3XChehe/project-3/TaiLieu_DroneFC_CRSF_DShot.docx

TÀI LIỆU KỸ THUẬT

DroneFC_CRSF_DShot

Firmware Điều Khiển Quadcopter trên ESP32

Thành phần | Linh kiện
Vi điều khiển | ESP32 WROOM32 38Pin
IMU | ICM-20602 (SPI, 10 MHz)
Cảm biến áp suất | BMP388 (I2C, 400 kHz)
Bộ thu RC | Radiomaster RP3 ELRS 2.4 GHz — CRSF 420000 baud
ESC | GOKU G55M 4-in-1 BLHeli32 — DShot600 qua RMT
Động cơ | RS2205 2300KV, khung 5", pin 3S 2200 mAh
Tay điều khiển | Pocket Crush ELRS (EdgeTX)

# MỤC LỤC

1 Tổng quan hệ thống

1.1 Kiến trúc phần cứng

1.2 Kiến trúc phần mềm — FreeRTOS

2 Giao tiếp CRSF (Crossfire Serial Protocol)

2.1 Đặc điểm giao thức

2.2 Cấu trúc khung dữ liệu CRSF

2.3 Thuật toán giải mã

2.4 Xử lý mất sóng (Failsafe)

3 Giao thức DShot600

3.1 Tại sao dùng DShot thay PWM?

3.2 Cấu trúc frame DShot

3.3 Triển khai qua RMT của ESP32

3.4 Quy đổi giá trị nội bộ → DShot

4 Đọc IMU — ICM-20602 qua SPI

4.1 Khởi tạo và hiệu chỉnh

4.2 Đọc số liệu thô

4.3 Hiệu chỉnh gyro (bias)

4.4 Hiệu chỉnh gia tốc kế (offset)

5 Ước lượng góc — Bộ lọc Kalman 1D

5.1 Vấn đề khi dùng riêng gyro hoặc riêng accelerometer

5.2 Kalman 1D: mô hình và phương trình

5.3 Tham số và cách chỉnh

6 Cảm biến áp suất BMP388 qua I2C

6.1 Cấu hình ODR / OSR / IIR

6.2 Bù nhiệt độ và áp suất

6.3 Đo cao độ gốc

7 Ước lượng độ cao — Kalman 2 trạng thái

7.1 Mô hình trạng thái

7.2 Bước dự đoán (Predict)

7.3 Bước hiệu chỉnh (Update)

7.4 Tham số và cách chỉnh

8 Thuật toán điều khiển PID xếp tầng

8.1 Tổng quan kiến trúc cascade

8.2 Bộ PID rời rạc — công thức chi tiết

8.3 Tầng ngoài: Góc nghiêng (Attitude)

8.4 Tầng trong: Tốc độ góc (Rate)

8.5 Tầng độ cao: Tốc độ thẳng đứng (Climb)

8.6 Bộ Mixer quad-X

8.7 Anti-windup và bleed integrator

9 Các chế độ bay

9.1 Chế độ Angle

9.2 Chế độ Alt Hold

9.3 Chế độ Failsafe

10 Hướng dẫn chỉnh PID

10.1 Nguyên tắc chỉnh cascade

10.2 Chỉnh tầng Rate

10.3 Chỉnh tầng Attitude

10.4 Chỉnh tầng Alt Hold

11 Debug và công cụ chẩn đoán

# 1. Tổng quan hệ thống

## 1.1 Kiến trúc phần cứng

Hệ thống firmware DroneFC_CRSF_DShot chạy trên vi điều khiển ESP32 WROOM32, kết nối với các linh kiện ngoại vi thông qua các giao thức chuẩn công nghiệp:

- ICM-20602 (IMU — gia tốc kế + con quay): giao tiếp SPI tốc độ 10 MHz, chip-select tại GPIO5.
- BMP388 (cảm biến áp suất để đo độ cao): giao tiếp I2C 400 kHz (Fast Mode), SDA=GPIO21, SCL=GPIO22, địa chỉ 0x76.
- Radiomaster RP3 ELRS (bộ thu RC): xuất giao thức CRSF qua UART2 (GPIO16/17), tốc độ 420000 baud.
- GOKU G55M 4-in-1 ESC BLHeli32: nhận lệnh DShot600 số qua 4 chân GPIO (27, 26, 25, 33), mỗi chân dùng 1 kênh RMT của ESP32.
- 4 motor RS2205 2300KV được điều khiển theo cấu hình quad-X tiêu chuẩn.

## 1.2 Kiến trúc phần mềm — FreeRTOS

Firmware sử dụng FreeRTOS (tích hợp sẵn trong Arduino ESP32) để chạy đồng thời ba tác vụ (task) với mức ưu tiên và tần số khác nhau trên hai lõi CPU:

Task | Core | Tần số | Ưu tiên | Chức năng
control_task | Core 1 | 500 Hz (2 ms) | 5 (cao nhất) | Đọc IMU, ước lượng góc/độ cao, PID, mixer, xuất ESC
rc_task | Core 0 | 500 Hz (2 ms) | 4 | Giải mã giao thức CRSF từ RP3, ghi shared_rc_ch[]
baro_task | Core 0 | 100 Hz (10 ms) | 2 | Đọc BMP388, ghi shared_baro_alt_m, in debug Serial

Giao tiếp giữa các task sử dụng Mutex (SemaphoreHandle_t) để bảo vệ vùng dữ liệu chung. Có ba mutex: mtx_rc (bảo vệ shared_rc_ch[]), mtx_baro (bảo vệ shared_baro_alt_m), và mtx_tlm (bảo vệ các biến telemetry để in debug). control_task dùng xSemaphoreTake(..., 0) — không chờ — để không bao giờ bị chặn, đảm bảo vòng điều khiển 500 Hz luôn chạy đúng chu kỳ.

# 2. Giao tiếp CRSF (Crossfire Serial Protocol)

## 2.1 Đặc điểm giao thức

CRSF (Crossfire Serial Protocol) là giao thức nối tiếp số được phát triển bởi Team BlackSheep (TBS), sau đó được ExpressLRS (ELRS) áp dụng rộng rãi. Radiomaster RP3 ELRS 2.4 GHz xuất dữ liệu kênh RC qua giao thức này. Đặc điểm nổi bật so với SBUS truyền thống:

- Tốc độ baud: 420000 — nhanh hơn SBUS (100000) gần 4×.
- Không đảo tín hiệu (non-inverted), ngược với SBUS phải đảo phần cứng.
- Format 8N1 (8 bit dữ liệu, không parity, 1 bit stop).
- Có CRC-8/DVB-S2 bảo vệ từng khung — rất hiếm lỗi bit không được phát hiện.
- ELRS ở chế độ 500 Hz gửi 1 khung mỗi 2 ms — đồng bộ tự nhiên với rc_task 500 Hz.
- Hỗ trợ telemetry hai chiều (từ FC lên TX) qua cùng cặp dây UART.
- 16 kênh trong mỗi khung (giống SBUS, nhưng có địa chỉ và CRC).

## 2.2 Cấu trúc khung dữ liệu CRSF

Mỗi khung CRSF "RC Channels Packed" gồm các trường theo thứ tự:

[ADDR 1B] [LEN 1B] [TYPE 1B] [PAYLOAD 22B] [CRC 1B] → Tổng 26 byte

ADDR : 0xC8 (Flight Controller) hoặc 0xEE (Broadcast)

LEN : số byte từ TYPE đến hết CRC = 22 + 1 + 1 = 24

TYPE : 0x16 = RC Channels Packed

PAYLOAD: 16 kênh × 11 bit = 176 bit = 22 byte, xếp liên tiếp không padding

CRC : CRC-8/DVB-S2, tính từ byte TYPE đến hết PAYLOAD (23 byte)

Giá trị mỗi kênh trong payload nằm trong khoảng 172–1811 (11-bit unsigned). Sau khi giải mã, firmware ánh xạ tuyến tính về dải quen thuộc 990–2010 (tương thích với thang 1000–2000 µs của PWM truyền thống):

ch_us = map(raw, 172, 1811, 990, 2010)

Giá trị giữa (stick ở trung tâm): raw = 992 → ch_us ≈ 1500

## 2.3 Thuật toán giải mã — Máy trạng thái

Hàm crsf_process_byte() thực hiện máy trạng thái (state machine) gom từng byte từ UART vào bộ đệm và xác nhận khung khi đủ dữ liệu:

- Bước 1 — Đồng bộ: Chờ byte addr (0xC8 hoặc 0xEE). Mọi byte trước đó bị bỏ qua. Khi nhận được byte addr hợp lệ, bắt đầu ghi vào bộ đệm và đặt cờ crsf_in_frame = true.
- Bước 2 — Đọc LEN: Byte thứ 2 là trường LEN. Kiểm tra 2 ≤ LEN ≤ 62; nếu ngoài giới hạn, reset máy trạng thái.
- Bước 3 — Gom payload: Tiếp tục nhận byte cho đến khi tổng số byte nhận = LEN + 2 (addr + len + nội dung).
- Bước 4 — Kiểm tra CRC: Tính CRC-8/DVB-S2 trên byte TYPE đến hết PAYLOAD, so sánh với byte CRC nhận được. Nếu không khớp, bỏ khung.
- Bước 5 — Giải mã kênh: Nếu TYPE = 0x16, gọi crsf_decode_channels() để tách 16 kênh 11-bit từ 22 byte payload.

Cách tách bit kênh — ví dụ kênh 0 và kênh 1:

ch[0] = (payload[0] | (payload[1] << 8)) & 0x07FF // 11 bit thấp nhất

ch[1] = (payload[1] >> 3 | (payload[2] << 5)) & 0x07FF // dịch 11 bit tiếp theo

Kỹ thuật này giống hệt SBUS về cách đóng gói bit. Mỗi kênh lấy 11 bit liên tiếp từ dòng byte, bất kể ranh giới byte, bằng cách dịch bit và mask 0x07FF.

## 2.4 Xử lý mất sóng (Failsafe)

Hàm rc_update() trả về true khi còn sóng, false khi mất sóng. Điều kiện mất sóng: không nhận được khung hợp lệ nào trong vòng 200 ms (hằng số CRSF_TIMEOUT_MS). Khi rc_ok = false, control_task kích hoạt MODE_FAILSAFE: drone giữ nguyên góc 0° và hạ độ cao với tốc độ 60 cm/s cho đến khi chạm đất rồi tự disarm.

# 3. Giao thức DShot600

## 3.1 Tại sao dùng DShot thay PWM?

Tiêu chí | PWM | DShot600
Loại tín hiệu | Analog (độ rộng xung) | Số (chuỗi bit)
Tần số cập nhật | 50–400 Hz (thường 391 Hz) | Lên đến 8000 Hz
Hiệu chỉnh ESC | Cần calibrate min/max | Không cần
Noise immunity | Thấp (nhiễu làm lệch xung) | Cao (CRC kiểm tra)
Telemetry | Không có | Có (tốc độ, dòng, nhiệt độ)
Độ trễ | ~2 ms (1 chu kỳ PWM) | <0.1 ms

## 3.2 Cấu trúc frame DShot

Mỗi frame DShot gồm 16 bit, gửi theo thứ tự MSB-first:

| 11 bit throttle | 1 bit telemetry | 4 bit CRC |

bit15 ......... bit5 bit4 bit3...bit0

Ý nghĩa giá trị throttle:

0 : Disarmed (motor tắt hoàn toàn)

1–47 : Lệnh đặc biệt (beep, đảo chiều, lưu cài đặt...)

48 : Idle tối thiểu khi đã armed (motor quay chậm)

2047 : Full throttle

Tính CRC DShot — XOR ba nhóm 4 bit của 12 bit (throttle + telemetry):

value = (throttle << 1) | telem_bit

crc = (value ^ (value >> 4) ^ (value >> 8)) & 0x0F

frame = (value << 4) | crc

Mã hóa từng bit bằng độ rộng xung (DShot600 — 600 kbit/s):

Bit '1': HIGH 1.25 µs (100 ticks@80MHz) + LOW 0.42 µs (34 ticks)

Bit '0': HIGH 0.625 µs (50 ticks@80MHz) + LOW 1.045 µs (84 ticks)

Chu kỳ bit = 1.67 µs → thời gian 1 frame = 16 × 1.67 ≈ 26.7 µs

## 3.3 Triển khai qua RMT của ESP32

ESP32 có ngoại vi RMT (Remote Control Transceiver) — bộ tạo/phân tích xung phần cứng. Firmware dùng 4 kênh RMT (CHANNEL_0 đến CHANNEL_3) cho 4 motor, mỗi kênh độc lập. Ưu điểm: CPU không bị chiếm trong khi phát xung — RMT tự động phát theo DMA trong khi control_task tiếp tục tính toán.

Cấu hình RMT:

clk_div = 1 → clock 80 MHz, 1 tick = 12.5 ns

mem_block_num = 1 → 64 item, đủ cho 16 bit DShot + 1 end marker

idle_level = LOW → line ở mức 0 giữa các frame (giống chuẩn DShot)

rmt_write_items(..., false) → non-blocking, không chờ xong

## 3.4 Quy đổi giá trị nội bộ → DShot

Để không phải sửa logic PID và mixer, firmware giữ nguyên thang nội bộ 800–1600 (tương tự PWM µs cũ), chỉ chuyển đổi ngay trước khi gửi:

internal ≤ ESC_IDLE (800) → DShot 0 (disarmed)

internal < ESC_MIN_ARMED (900) → DShot 0 (dưới mức arm)

ESC_MIN_ARMED..ESC_MAX (900..1600) → DShot 48..2047 (map tuyến tính)

# 4. Đọc IMU — ICM-20602 qua SPI

## 4.1 Khởi tạo

Firmware cấu hình ICM-20602 với các thang đo rộng nhất để phù hợp drone racing:

ACCEL_CONFIG = 0x18 → thang ±16g (ACC_LSB_PER_G = 2048 LSB/g)

GYRO_CONFIG = 0x18 → thang ±2000°/s (GYRO_LSB_PER_DPS = 16.4 LSB/°s)

CONFIG (DLPF gyro) → IMU_DLPF_GYRO = 0x06 (bộ lọc thông thấp phần cứng)

ACCEL_CONFIG2 (DLPF acc) → IMU_DLPF_ACC = 0x05

DLPF (Digital Low Pass Filter) tích hợp trong chip giúp lọc nhiễu tần số cao trước khi dữ liệu vào thanh ghi, giảm nhiễu do rung động khung.

## 4.2 Đọc số liệu thô

Firmware đọc 6 thanh ghi accelerometer (ACCEL_XOUT_H đến ACCEL_ZOUT_L) và 6 thanh ghi gyroscope (GYRO_XOUT_H đến GYRO_ZOUT_L) trong hai giao dịch SPI riêng. Với SPI, bit7 của byte địa chỉ = 1 để đọc, = 0 để ghi.

// Đọc accelerometer (burst read 6 byte)

SPI.transfer(REG_ACCEL_XOUT_H | 0x80); // bit7=1: read

ax = (SPI.transfer(0) << 8) | SPI.transfer(0);

// Tương tự cho ay, az, gx, gy, gz

Quy đổi từ số nguyên thô (LSB) sang đơn vị vật lý:

rate_roll_dps = gx_lsb / 16.4f [°/s]

acc_x_g = ax_lsb / 2048.0f [g]

## 4.3 Hiệu chỉnh gyro (Bias Calibration)

Khi nguồn cấp lần đầu, gyro bị offset (bias) — tức là ngay cả khi drone đứng yên, nó vẫn báo một tốc độ xoay khác 0. Firmware đo bias này và trừ đi trong mọi lần đọc:

- Lấy 500 mẫu liên tiếp (~5 ms/mẫu). Tính tổng roll, pitch, yaw.
- So sánh với đợt đo trước. Nếu lệch > STABLE_LIMIT (40 LSB) thì đo lại.
- Khi hai đợt đo liên tiếp ổn định: bias = tổng / 500 (°/s).
- Sau đó mọi lần đọc gyro đều trừ bias: rate = raw - bias.

Vòng lặp ổn định đảm bảo nếu người dùng đang cầm drone lúc cắm điện, bias đo được sẽ sai và firmware tự đo lại cho đến khi drone đứng yên thật sự.

## 4.4 Hiệu chỉnh gia tốc kế (Offset)

Gia tốc kế có thể bị lệch cơ học do cảm biến gắn không hoàn hảo trên PCB. Khi drone nằm phẳng, lý tưởng phải đọc X=0g, Y=0g, Z=+1g. Firmware có chế độ hiệu chỉnh gia tốc kế (bật #define CALIBRATE_ACCEL):

- Đo trung bình 2000 mẫu (4 giây), drone phải nằm hoàn toàn phẳng.
- In ra 3 giá trị offset cần gán vào ACC_OFFSET_X/Y/Z_G.
- Kiểm tra: nếu Z < 0.80g → drone bị lật ngược; nếu |X|>0.30g hoặc |Y|>0.30g → bề mặt không phẳng.

#define ACC_OFFSET_X_G -mean_x

#define ACC_OFFSET_Y_G -mean_y

#define ACC_OFFSET_Z_G (1.0 - mean_z)

Offset được cộng vào mỗi lần đọc: acc_x = raw_x + ACC_OFFSET_X_G

# 5. Ước lượng góc — Bộ lọc Kalman 1D

## 5.1 Vấn đề khi dùng riêng một nguồn

Có hai cách đo góc nghiêng (roll/pitch), mỗi cách có nhược điểm riêng:

- Chỉ dùng Gyroscope: tích phân tốc độ góc → góc. Chính xác trong ngắn hạn, nhưng tích phân tích lũy sai số (trôi góc) theo thời gian.
- Chỉ dùng Accelerometer: tính góc từ vectơ gia trọng lực. Không trôi về dài hạn, nhưng rất nhạy với rung động và gia tốc phi tuyến khi drone cơ động.

Giải pháp: Bộ lọc Kalman 1D kết hợp cả hai — gyro cung cấp dự đoán nhanh, accelerometer kéo về đúng hướng khi có sai lệch.

## 5.2 Kalman 1D: mô hình và phương trình

Trạng thái là góc (một chiều). Mô hình:

Dự đoán (Predict):

θ_pred = θ_prev + Δt × ω_gyro // tích phân gyro

P_pred = P_prev + Δt² × σ_process² // phương sai tăng dần

Hiệu chỉnh (Update):

K = P_pred / (P_pred + σ_measure²) // Kalman gain

θ = θ_pred + K × (θ_acc - θ_pred) // kéo về phép đo

P = (1 - K) × P_pred // thu hẹp phương sai

Trong code (hàm imu_kalman_1d):

state_deg += DT_CTRL * rate_dps; // DT_CTRL = 0.002s

variance += DT_CTRL * DT_CTRL * 1.0 * 1.0;// σ_process = 1 °/s

gain = variance / (variance + 3.0*3.0); // σ_measure = 3°

state_deg += gain * (measure_deg - state_deg);

variance = (1.0 - gain) * variance;

Góc từ accelerometer được tính bằng hàm atan2:

acc_roll_deg = atan(ay / sqrt(ax² + az²)) × RAD_TO_DEG

acc_pitch_deg = -atan(ax / sqrt(ay² + az²)) × RAD_TO_DEG

## 5.3 Tham số và cách chỉnh

• σ_process = 1 °/s: Độ lệch chuẩn nhiễu gyro. Tăng → tin gyro ít hơn, bộ lọc kéo về accelerometer mạnh hơn (phản ứng chậm hơn với rung động).

• σ_measure = 3°: Độ lệch chuẩn nhiễu accelerometer. Tăng → tin accelerometer ít hơn, bộ lọc phụ thuộc gyro nhiều hơn (có thể trôi góc lâu hơn).

• P_init = 4 (2²): Phương sai ban đầu. Giá trị nhỏ = khởi động tin góc ban đầu; giá trị lớn = không tin, hội tụ nhanh về accelerometer.

⚠ Kalman 1D này không xử lý trục yaw vì không có la bàn (magnetometer). Yaw chỉ được điều khiển theo tốc độ xoay (rate control), không theo góc tuyệt đối.

# 6. Cảm biến áp suất BMP388 qua I2C

## 6.1 Cấu hình ODR / OSR / IIR

Firmware cấu hình BMP388 với các thông số sau (đã tối ưu cho Alt Hold):

ODR = 50 Hz (1 mẫu mỗi 20 ms) — đủ cho alt hold, giảm nhiễu tốt hơn 200 Hz

OSR áp suất = x8 — lấy mẫu bội 8 lần rồi trung bình, độ phân giải cao hơn

OSR nhiệt độ = x1 — không cần bội vì bù nhiệt không yêu cầu chính xác cao

IIR filter = 3 — bộ lọc IIR phần cứng trong chip, giảm nhiễu áp suất

ODR và OSR phải tương thích theo ràng buộc thời gian của datasheet Bosch. Thời gian đo: 234 + (392 + 2^3 × 2020) + (163 + 2020) ≈ 18.97 ms. Chu kỳ ODR 50 Hz = 20 ms, vừa lọt. Nếu đặt ODR nhanh hơn sẽ bị conf_err.

## 6.2 Bù nhiệt độ và áp suất

BMP388 lưu hệ số hiệu chỉnh riêng cho từng chip trong thanh ghi CALIB (21 byte). Hai hàm baro_compensate_temp() và baro_compensate_press() thực hiện bù theo đúng phương trình polynomial do Bosch định nghĩa trong datasheet. Sau đó, áp suất đã bù (Pa) được chuyển sang độ cao (m) bằng công thức khí quyển chuẩn ISA:

altitude_m = 44330 × (1 − (P / P0)^0.1903)

với P0 = 101325 Pa (áp suất ngang mực nước biển tiêu chuẩn)

## 6.3 Đo cao độ gốc

Lúc khởi động, hàm baro_measure_reference() lấy trung bình 50 mẫu hợp lệ để xác định baro_alt_ref_m — cao độ tuyệt đối của điểm cất cánh. Sau đó, baro_get_altitude_m() = baro_alt_abs_m − baro_alt_ref_m cho ra độ cao tương đối so với điểm cất cánh (≈ 0 khi đặt xuống đất).

# 7. Ước lượng độ cao — Kalman 2 trạng thái

## 7.1 Mô hình trạng thái

Bộ lọc Kalman 2 trạng thái ước lượng đồng thời độ cao z (cm) và tốc độ thẳng đứng vz (cm/s). Đầu vào (control input) là gia tốc thẳng đứng đã trừ trọng lực, lấy từ IMU. Phép đo là độ cao từ barometer.

Vector trạng thái: S = [z, vz]ᵀ

Đầu vào: u = acc_earth_z (cm/s²)

Phép đo: M = baro_alt (cm)

Ma trận chuyển trạng thái F:

F = [1 Δt ] (z mới = z + vz×Δt)

[0 1 ] (vz mới = vz)

Ma trận đầu vào G:

G = [0.5×Δt²] (z tăng do gia tốc)

[ Δt ] (vz tăng tuyến tính)

Ma trận quan sát H = [1, 0] (chỉ đo z, không đo vz)

## 7.2 Bước dự đoán (Predict)

S = F·S + G·u // dự đoán trạng thái mới

P = F·P·Fᵀ + Q // dự đoán hiệp phương sai sai số

với Q = G·Gᵀ × σ_acc² = G·Gᵀ × 4² (σ_acc = 4 cm/s²)

## 7.3 Bước hiệu chỉnh (Update)

L = H·P·Hᵀ + R // hiệp phương sai phần dư (1×1 scalar)

K = P·Hᵀ / L // Kalman gain (2×1)

S = S + K·(M − H·S) // hiệu chỉnh theo phép đo baro

P = (I − K·H)·P // cập nhật hiệp phương sai

với R = σ_baro² = 30² = 900 cm²

Lưu ý quan trọng: Firmware gọi CẢ predict lẫN update ở MỖI vòng 500 Hz, kể cả khi baro chưa có mẫu mới (baro chỉ có 50 Hz). Lý do: với bộ tham số này, Kalman gain K rất nhỏ. Chỉ bằng cách áp dụng 500 lần/giây mới đủ lực kéo ước lượng bám theo baro. Nếu chỉ update khi baro có mẫu mới (~50 Hz), tốc độ thẳng đứng vz sẽ tích phân thuần từ gia tốc và trôi vô hạn.

## 7.4 Tham số và cách chỉnh

• σ_acc = 4 cm/s²: Nhiễu gia tốc giả định. Tăng → P tăng nhanh hơn → K lớn hơn → tin baro nhiều hơn. Giảm → tin IMU nhiều hơn, drone ít bị baro nhiễu nhưng có thể trôi cao độ.

• σ_baro = 30 cm: Nhiễu barometer giả định. Tăng → R lớn → K nhỏ → bộ lọc ít tin baro. Giảm → tin baro nhiều hơn, nhưng dễ bị nhiễu baro làm drone nhảy độ cao.

# 8. Thuật toán điều khiển PID xếp tầng

## 8.1 Tổng quan kiến trúc cascade

Firmware dùng kiến trúc PID xếp tầng (cascade / nested PID) — đây là cấu trúc tiêu chuẩn trong hầu hết flight controller hiện đại (Betaflight, PX4, ArduPilot):

┌────────────────────────────────────────────────────────────────┐

│ TẦY NGOÀI (Attitude/Angle): │

│ setpoint_angle (°) → [PID_TILT] → setpoint_rate (°/s) │

│ │

│ TẦNG TRONG (Rate): │

│ setpoint_rate (°/s) → [PID_RATE] → u (lệnh motor) │

│ │

│ TẦNG ĐỘ CAO (Alt Hold): │

│ setpoint_climb (cm/s) → [PID_CLIMB] → u_throttle │

└────────────────────────────────────────────────────────────────┘

Ưu điểm của cascade: tầng trong (Rate) phản ứng rất nhanh với biến động tốc độ góc (nhiễu gió, va chạm), trong khi tầng ngoài (Attitude) điều chỉnh chậm hơn để theo góc mong muốn. Tách biệt này giúp chỉnh từng tầng độc lập và dễ dàng hơn nhiều.

## 8.2 Bộ PID rời rạc — công thức chi tiết

Hàm pid_step() thực hiện PID rời rạc với:

• Khâu tỉ lệ P:

p_term = Kp × error

• Khâu tích phân I (quy tắc hình thang — Trapezoidal integration):

integral += Ki × (error + prev_error) × Δt / 2

// Hình thang: trung bình sai số hiện tại và trước, chính xác hơn hình chữ nhật

integral = clamp(integral, -I_LIMIT, +I_LIMIT) // chống windup

• Khâu vi phân D (sai phân lùi — Backward difference):

d_term = Kd × (error - prev_error) / Δt

// Sai phân lùi: an toàn hơn sai phân trung tâm, không nhìn trước

• Đầu ra tổng và giới hạn:

u = p_term + integral + d_term

u = clamp(u, -U_LIMIT, +U_LIMIT)

prev_error = error // lưu cho vòng tiếp theo

## 8.3 Tầng ngoài: Góc nghiêng (Attitude)

Nhận góc mong muốn (roll_sp, pitch_sp) từ cần gạt, so sánh với góc thực từ Kalman, xuất tốc độ góc mong muốn cho tầng trong:

rate_roll_sp = pid_tilt_roll (roll_deg, roll_sp_deg) // KP=10, KI=0, KD=0

rate_pitch_sp = pid_tilt_pitch(pitch_deg, pitch_sp_deg) // KP=10, KI=0, KD=0

KI=0 và KD=0 ở tầng này là chủ ý: tầng ngoài chỉ cần P đơn giản vì sai số góc tích phân đã được tầng trong xử lý. KP_TILT=10 nghĩa là: lệch 1° → yêu cầu tốc độ xoay 10°/s.

## 8.4 Tầng trong: Tốc độ góc (Rate)

Nhận tốc độ góc mong muốn từ tầng ngoài, so sánh với tốc độ thực từ gyro, xuất tín hiệu điều khiển motor (u_roll, u_pitch, u_yaw):

u_roll = pid_rate_roll (rate_roll_dps, rate_roll_sp) // KP=0.5, KI=1.4, KD=0.03

u_pitch = pid_rate_pitch(rate_pitch_dps, rate_pitch_sp) // KP=0.5, KI=1.4, KD=0.03

u_yaw = pid_rate_yaw (rate_yaw_dps, yaw_rate_sp) // KP=1.0, KI=10, KD=0

Yaw chỉ có tầng Rate (không có tầng Attitude) vì không đo góc yaw tuyệt đối. Cần gạt Rudder trực tiếp đặt tốc độ xoay mong muốn (°/s).

## 8.5 Tầng độ cao: Tốc độ thẳng đứng (Climb)

Nhận tốc độ lên xuống mong muốn (climb_sp_cms) từ cần Throttle (ở chế độ Alt Hold), so sánh với tốc độ thực từ Kalman độ cao, xuất bù ga:

u_throttle = ESC_IDLE + pid_climb(kf_climb_cms, climb_sp_cms) // KP=3, KI=15, KD=0

Hàm pid_step_climb() có hai điểm khác biệt so với PID thông thường:

- Khâu tích phân KHÔNG được phép âm (tối thiểu = 0). Lý do: khâu tích phân gánh phần ga treo máy (hover throttle), không được kéo ga xuống âm vì drone cần một lượng ga tối thiểu để lơ lửng.
- Khâu tỉ lệ bị chặn riêng (P_LIM_CLIMB = 200). Lý do: nhiễu baro đột ngột (do thay đổi áp suất, cánh quạt tạo áp...) không được đẩy ga vọt lên mạnh.

## 8.6 Bộ Mixer quad-X

Sau khi PID tính ra u_roll, u_pitch, u_yaw, u_throttle, Mixer kết hợp chúng thành lệnh cho từng motor theo cấu hình quad-X tiêu chuẩn:

M3 (↙CCW) M1 (↗CW)

× ×

M2 (↖CW) M4 (↘CCW)

ESC_1 (trước phải, CW ) = throttle - roll - pitch - yaw

ESC_2 (sau trái, CW ) = throttle + roll + pitch - yaw

ESC_3 (trước trái, CCW) = throttle + roll - pitch + yaw

ESC_4 (sau phải, CCW) = throttle - roll + pitch + yaw

Dấu +/- cho roll/pitch theo quy tắc: khi roll dương (nghiêng phải), motor bên phải cần giảm ga, motor bên trái tăng ga. Yaw: motor CW và CCW được nhóm ngược dấu để tạo mô-men xoay.

## 8.7 Anti-windup và bleed integrator

Có hai cơ chế chống windup (tích phân bão hòa) trong firmware:

- Clamp tích phân: nếu integral vượt I_LIMIT, kẹp lại. Ngăn tích phân tăng mãi khi drone ở saturation.
- Bleed integrator (pid_bleed_integrators): khi ga < 830 mà chưa disarm, nhân tích phân với 0.9 mỗi vòng → tích phân tự xả dần về 0. Tránh drone bật dậy khi ga tăng trở lại.
- Reset hoàn toàn (pid_reset_all): khi disarm, tất cả tích phân = 0. Tránh tích phân cũ còn lại từ chuyến bay trước.

# 9. Các chế độ bay

## 9.1 Chế độ Angle (Ổn định góc)

Đây là chế độ mặc định, phù hợp cho người mới bắt đầu. Cần gạt Roll/Pitch đặt góc nghiêng mong muốn (±20°, hằng số LIM_TILT_DEG). Khi nhả cần, drone tự về góc 0° (phẳng). Ga (Throttle) điều khiển trực tiếp công suất motor (được scale 80%).

u_throttle = rc_ch[CH_THROTTLE] × 0.8

u_roll = pid_rate_roll(rate, pid_tilt_roll(roll, roll_sp))

u_pitch = pid_rate_pitch(rate, pid_tilt_pitch(pitch, pitch_sp))

u_yaw = pid_rate_yaw(rate, yaw_rate_sp)

## 9.2 Chế độ Alt Hold (Giữ độ cao)

Drone tự duy trì độ cao. Cần Throttle điều khiển tốc độ lên xuống (±100 cm/s). Khi Throttle ở giữa (1500), tốc độ mong muốn = 0 → drone giữ nguyên độ cao. Roll/Pitch/Yaw hoạt động giống Angle mode.

climb_sp = (rc_throttle - 1500) / (500 / LIM_CLIMB_RATE_CMS)

u_throttle = ESC_IDLE + pid_climb(kf_climb_cms, climb_sp)

Đặc điểm: throttle offset (ESC_IDLE = 800) dùng làm điểm cơ sở. Khâu tích phân của pid_climb tự học hover throttle (lượng ga cần để bay tại chỗ) trong vài giây đầu sau khi chuyển sang Alt Hold.

## 9.3 Chế độ Failsafe (Mất sóng)

Kích hoạt tự động khi không nhận được tín hiệu RC hợp lệ trong 200 ms. Drone tự hạ cánh với tốc độ 60 cm/s (FAILSAFE_DESCENT_CMS = -60), giữ góc roll/pitch = 0°, yaw không xoay.

u_throttle = ESC_IDLE + pid_climb(kf_climb_cms, -60.0f) // hạ 60 cm/s

u_roll = pid_rate_roll(rate, pid_tilt_roll(roll, 0)) // giữ phẳng

Tự disarm khi: u_throttle gần ESC_MIN_ARMED VÀ tốc độ thẳng đứng < 5 cm/s VÀ đã qua 2 giây kể từ mất sóng → coi như đã chạm đất.

# 10. Hướng dẫn chỉnh PID

## 10.1 Nguyên tắc chỉnh cascade

Với PID cascade, PHẢI chỉnh từ tầng trong ra ngoài: chỉnh Rate PID trước, sau đó mới chỉnh Attitude PID, cuối cùng mới chỉnh Alt Hold PID. Nếu Rate PID không ổn định, tầng ngoài không thể hoạt động đúng.

⚠ Luôn tháo cánh quạt khi thử nghiệm trên bàn. Chỉ lắp cánh khi bay thực.

## 10.2 Chỉnh tầng Rate (KP/KI/KD_RATE)

Triệu chứng | Biểu hiện | Cách sửa
KP_RATE quá nhỏ | Drone phản ứng chậm, không bám tốc độ góc mong muốn. | Tăng KP_RATE.
KP_RATE quá lớn | Drone rung nhẹ, tiếng "buzz" từ motor ở tần số cao. | Giảm KP_RATE từng bước 0.05.
KI_RATE quá nhỏ | Drone không về góc 0 sau khi thả cần. | Tăng KI_RATE.
KI_RATE quá lớn | Dao động chậm, drone "vẽ vòng tròn" khi hover. | Giảm KI_RATE.
KD_RATE nhỏ | Drone overshoots, dao động sau khi thay đổi góc nhanh. | Tăng KD_RATE từng bước 0.002.
KD_RATE lớn | Rung động tần số cao, motor nóng. | Giảm KD_RATE.

## 10.3 Chỉnh tầng Attitude (KP_TILT)

Sau khi Rate ổn định, chỉnh KP_TILT (hiện tại = 10). KP_TILT quá nhỏ: drone "ì", phản ứng chậm với cần gạt. KP_TILT quá lớn: drone rung ở tần số thấp hơn Rate, dao động góc. Thử nghiệm bằng DEBUG_ATTITUDE: quan sát roll_deg bám theo roll_sp_deg, không có độ trễ lớn và không dao động.

// Bật debug attitude:

#define DEBUG_ATTITUDE

// Output: roll_sp | roll_deg | pitch_sp | pitch_deg (CSV)

## 10.4 Chỉnh tầng Alt Hold (KP/KI_CLIMB)

Sau khi Angle mode ổn định, thử Alt Hold bằng DEBUG_ALTITUDE. KP_CLIMB quá nhỏ: drone trôi độ cao, không bám climb_sp. KP_CLIMB quá lớn: drone "nhảy" lên xuống. KI_CLIMB là quan trọng nhất: nó tích phân để học hover throttle. Nếu KI_CLIMB nhỏ: mất nhiều thời gian học hover, drone hạ dần. Nếu KI_CLIMB lớn: tích phân overshoot, drone vọt lên khi chuyển mode.

// Bật debug altitude:

#define DEBUG_ALTITUDE

// Output: alt_cm | climb_cms | climb_sp_cms (CSV)

# 11. Debug và công cụ chẩn đoán

Firmware tích hợp 6 chế độ debug, bật bằng cách uncomment dòng #define trong file .ino chính. Mỗi lần CHỈ BẬT MỘT chế độ (in quá nhiều dữ liệu làm chậm task):

Chế độ | Dữ liệu xuất ra
DEBUG_ATTITUDE | roll_sp, roll, pitch_sp, pitch (độ) — xem góc bám theo cần gạt
DEBUG_RATE | rate_roll_sp, rate_roll, rate_pitch_sp, rate_pitch (°/s) — xem tốc độ góc
DEBUG_ALTITUDE | alt_cm, climb_cms, climb_sp_cms — xem độ cao và tốc độ thẳng đứng
DEBUG_RC | ch1..ch6, arm, mode, rc_ok, armed, flight_mode — kiểm tra tín hiệu RC
DEBUG_ACC_OFFSET | ax, ay, az (g, lọc IIR 0.02) — đo offset gia tốc kế khi nằm phẳng
DEBUG_LOOP_TIME | loop_us — kiểm tra chu kỳ vòng điều khiển, phải ≈ 2000 µs

Để đọc debug: mở Serial Monitor trong Arduino IDE ở tốc độ 500000 baud, hoặc dùng Serial Plotter để vẽ đồ thị trực tiếp (chọn CSV output ở trên).

Lưu ý: debug in cách 5 tick baro_task (100 Hz / 5 = 20 Hz) để không quá tải Serial.
