3XChehe/project-3/HUONG_DAN_TOAN_DIEN_PID_DRONE_ESP32.docx

TÀI LIỆU HƯỚNG DẪN KỸ THUẬT CHUYÊN ĐỀ

BỘ ĐIỀU KHIỂN PID & CẨM NANG CÂN CHỈNH DRONE (ESP32)

Giải thích chi tiết từ bản chất vật lý cho người mới bắt đầu đến cấu trúc Cascaded PID trong mã nguồn KyThuatUAV_FC_level_1 và quy trình tinh chỉnh thực chiến.

THÔNG TIN HỆ THỐNG & CĂN CỨ TÀI LIỆU
• Dự án mã nguồn: Mạch bay ESP32 — Kỹ Thuật UAV (Level 1: Angle + Alt Hold)
• Nền tảng vi điều khiển: ESP32-WROOM-DA (Dual-Core 240 MHz, FreeRTOS, chu kỳ 500 Hz / 2ms)
• Cảm biến: IMU ICM-20602 (SPI 10 MHz), Áp suất BMP388 (I2C)
• Căn cứ phân tích: File pid.ino, KyThuatUAV_FC_level_1.ino, Cẩm nang học Drone ESP32 và Tài liệu tự học.

CHƯƠNG 1: PID LÀ GÌ? (GIẢI THÍCH TRỰC QUAN CHO NGƯỜI MỚI)

Trong lĩnh vực tự động hóa và điều khiển học, PID (Proportional - Integral - Derivative) là thuật toán điều khiển vòng kín (Feedback Control) phổ biến và quan trọng nhất trên thế giới. Để hiểu PID một cách đơn giản và trực quan nhất mà không cần đến toán học phức tạp, hãy hình dung bài toán thực tế sau đây.

1.1 Câu chuyện chiếc xe dừng đèn đỏ

Bạn đang lái một chiếc ô tô và mục tiêu của bạn là dừng xe chính xác ngay sát vạch sơn dừng đèn đỏ:
• Sai số (Error) = (Vị trí vạch đích) - (Vị trí hiện tại của chiếc xe).
• Khi xe còn cách xa vạch, sai số dương (cần đi tới).
• Khi xe lỡ vượt quá vạch, sai số âm (cần lùi lại).
• Mục tiêu tối thượng của bạn là đưa Sai số về chính xác bằng 0.

Để làm được việc này, bộ não của bạn liên tục tính toán lực đạp chân ga hoặc chân phanh dựa trên ba góc nhìn về thời gian: Hiện tại, Quá khứ và Tương lai. Ba góc nhìn này chính là P, I và D.

┌──────────────────────────────────────────────┐
│ BỘ ĐIỀU KHIỂN PID │
│ │
Mục tiêu │ ┌──► [ P ] Phản ứng SAI SỐ HIỆN TẠI ──┐ │ Lực điều khiển
(Góc/Vị trí) ───┐ │ │ │ │ (Ga/Phanh)
▼ │ │ ▼ │
[+]───┼───┼──► [ I ] Khắc phục SAI SỐ QUÁ KHỨ ──►[+]─┼────────► Hệ thống
▲ - │ │ (Tích lũy cộng dồn) ▲ │ (Xe/Drone)
│ │ │ │ │ │
Thực tế ─────┴────┤ └──► [ D ] Dự đoán SAI SỐ TƯƠNG LAI ────┘ │ │
(Cảm biến) │ (Chiếc phanh hãm đà) │ │
└──────────────────────────────────────────────┘ │
▲ │
└───────────────── Đường phản hồi ──────────────────────┘

1.2 Phân tích chi tiết ba thành phần P - I - D

A. Khâu P (Proportional — Tỉ lệ): «Nhìn vào HIỆN TẠI»

• Bản chất: Sai số ở thời điểm hiện tại lớn bao nhiêu thì phản xạ tác động một lực tỉ lệ thuận bấy nhiêu.
• Trong ví dụ lái xe: Cách vạch 50m (sai số lớn) thì đạp ga mạnh; cách vạch 2m (sai số nhỏ) thì đạp ga nhẹ nhàng.
• Ưu điểm: Phản xạ nhanh, tức thời, là thành phần sinh lực chủ đạo của hệ thống.
• Hai nhược điểm sống còn nếu chỉ dùng một mình P:
1. Quán tính & Vọt lố (Overshoot): Xe lao tới gần vạch rất nhanh, dù chân ga đã nhả bớt nhưng do quán tính khối lượng lớn, chiếc xe vẫn trượt vọt lố qua vạch đèn đỏ trước khi dừng lại được.
2. Sai số tĩnh (Steady-State Error): Tưởng tượng chiếc xe đang dừng trên một con dốc ngược có trọng lực kéo xe tụt lùi. Khi xe tiến gần tới vạch, sai số chỉ còn 0.5m, lực đạp ga do P sinh ra quá nhỏ, chỉ vừa đủ cân bằng với trọng lực dốc khiến xe dừng khựng lại ở cách vạch 0.5m mà KHÔNG BAO GIỜ chạm tới đích!

B. Khâu I (Integral — Tích phân): «Nhìn vào QUÁ KHỨ»

• Bản chất: Cộng dồn tất cả các sai số theo thời gian trôi qua. Sai số dù nhỏ đến đâu, nhưng nếu cứ tồn tại dai dẳng, khâu I sẽ gom góp lại thành một lực bù ngày càng lớn.
• Trong ví dụ con dốc: Chiếc xe bị đứng khựng cách vạch 0.5m. Khâu I sẽ đếm thời gian: «1 giây trôi qua vẫn lệch... 2 giây trôi qua vẫn lệch... 3 giây...». Giá trị tích phân tăng dần, ép chân ga tự động nhấn sâu thêm cho đến khi lực đẩy thắng hoàn toàn trọng lực dốc và đưa xe chạm đúng vạch 0.
• Ưu điểm: Xóa sạch 100% sai số tĩnh, đảm bảo độ chính xác tuyệt đối ở trạng thái ổn định.
• Nhược điểm: Khâu I có tính trễ («thù dai»). Nếu tích lũy quá mức trong thời gian dài, khi xe đã về tới đích rồi nhưng lực I vẫn chưa tiêu biến kịp, làm xe tiếp tục bị đẩy vọt lố qua vạch.

C. Khâu D (Derivative — Vi phân): «Dự đoán TƯƠNG LAI»

• Bản chất: Đo lường tốc độ thay đổi của sai số (đạo hàm bậc nhất theo thời gian). Khâu D không quan tâm bạn đang ở đâu, nó chỉ quan tâm bạn đang lao nhanh hay chậm về phía đích để đóng vai trò như CHIẾC PHANH / BỘ GIẢM XÓC.
• Trong ví dụ lái xe: Bạn chỉ còn cách vạch 5m nhưng đồng hồ tốc độ chỉ 80 km/h (sai số đang thu hẹp với tốc độ chóng mặt). Khâu D nhìn thấy trước nguy cơ thảm họa trong giây tiếp theo và lập tức đạp phanh gấp để dập tắt đà lao của xe.
• Ưu điểm: Hãm quán tính, chống vọt lố, giúp hệ thống ổn định cực nhanh và dứt khoát.
• Nhược điểm: Khâu D khuếch đại cực mạnh các tín hiệu có tần số cao. Nếu mặt đường mấp mô (nhiễu cảm biến, động cơ rung), khâu D sẽ hiểu nhầm xe đang thay đổi vận tốc liên hồi, dẫn đến việc đạp phanh/ga giật cục liên tục.

1.3 Bảng tổng hợp vai trò của 3 thành phần

Thành phần | Ý nghĩa vật lý | Ưu điểm chính | Tác hại khi đặt quá cao
Khâu P (Kp) Tỉ lệ | Lực đẩy tỉ lệ thuận với độ lệch hiện tại | Phản ứng tức thì, kéo hệ thống hướng về đích nhanh chóng | Gây vọt lố (overshoot) và dao động rung lắc tần số cao
Khâu I (Ki) Tích phân | Lực bù cộng dồn theo thời gian sai số tồn tại | Triệt tiêu hoàn toàn sai số tĩnh, bù trọng lực hoặc gió lệch | Phản ứng trễ, tích lũy dư thừa gây lắc lư chậm biên độ lớn
Khâu D (Kd) Vi phân | Chiếc phanh hãm theo tốc độ co giãn của sai số | Dập tắt quán tính dao động, giúp dừng góc dứt khoát | Khuếch đại nhiễu rung cơ học, làm nóng và rít động cơ

CHƯƠNG 2: ỨNG DỤNG PID TRONG DRONE QUADCOPTER (ESP32)

Khác với ô tô hay tàu thủy, một chiếc Drone 4 cánh quạt (Quadcopter) là một hệ thống mất cân bằng tự nhiên hoàn toàn (Naturally Unstable System). Thân drone không có bất kỳ điểm tựa cơ học nào trong không gian ngoài lực nâng của 4 cánh quạt. Nếu một cơn gió thổi làm nghiêng 1 độ, quán tính sẽ lập tức khiến nó nghiêng 2 độ, 5 độ, lật nhào và rơi xuống đất chỉ trong vòng một phần mười giây. Do đó, vòng lặp điều khiển phản hồi PID là trái tim sống còn của máy bay.

2.1 Vòng lặp thời gian thực 500 Hz trên ESP32

Trong firmware của dự án này, hệ điều hành thời gian thực FreeRTOS phân chia tác vụ vào Nhân 1 (Core 1) của ESP32 chạy độc lập ở tần số 500 Hz (đúng 2 mili-giây cho mỗi vòng lặp). Cứ mỗi 2ms, tiến trình điều khiển thực hiện chuỗi 5 bước:

1. Đọc cảm biến quán tính IMU (ICM-20602) qua bus SPI tốc độ cao 10 MHz.
2. Thuật toán lọc Kalman 1D kết hợp Gyro và Accel để ước lượng góc nghiêng Roll và Pitch thực tế.
3. Thuật toán Kalman 2D ma trận kết hợp BMP388 và gia tốc Z để ước lượng độ cao và vận tốc thẳng đứng.
4. Bộ điều khiển PID tính toán độ lệch và xuất ra 4 giá trị lực điều khiển (u_throttle, u_roll, u_pitch, u_yaw).
5. Bộ trộn Mixer biến đổi 4 biến điều khiển thành xung PWM LEDC (391 Hz, độ rộng 1000 - 2000 µs) cấp cho 4 ESC.

2.2 Kiến trúc PID xếp tầng (Cascaded PID Controller)

Nếu ta chỉ áp dụng một bộ PID đơn giản lấy sai số góc nghiêng rồi nhân ra thẳng xung động cơ, drone sẽ cực kỳ khó điều khiển và dễ mất kiểm soát khi có gió hoặc rung động. Cấu trúc chuẩn mực quốc tế (áp dụng trong ArduPilot, PX4 và dự án này) là sử dụng PID XẾP TẦNG (Cascaded Loop) chia làm hai tầng lồng nhau:

Góc mong muốn Tốc độ góc mong muốn Lực điều khiển u
từ cần gạt RC (độ/giây, max 400) (cấp cho Mixer)
│ │ │
▼ ▼ ▼
┌─────────────┐ ┌──────────────┐ ┌─────────────┐
│ TẦNG NGOÀI │ │ TẦNG TRONG │ │ │
│ (Góc/Tilt) ├──────────────────►│ (Tốc độ góc/ ├───────────────►│ BỘ TRỘN ├──► 4 Motor
│ │ │ Rate) │ │ MIXER │
└─────────────┘ └──────────────┘ └─────────────┘
▲ ▲
│ │
Góc đo được Tốc độ góc đo được
(Kalman Filter) (ICM-20602 Gyro 500Hz)

• Tầng ngoài (Tilt Controller — Góc nghiêng): So sánh góc mong muốn từ tay cầm và góc ước lượng từ Kalman. Khâu này chỉ sử dụng hệ số tỉ lệ Kp (KP_TILT = 10.0). Đầu ra của nó là TỐC ĐỘ GÓC MONG MUỐN (độ/giây). Không dùng khâu I ở tầng này để tránh hiện tượng tương tác động học gây dao động với tầng trong.

• Tầng trong (Rate Controller — Tốc độ góc): So sánh tốc độ góc mong muốn với tốc độ góc đo thực tế trực tiếp từ Gyroscope. Tầng này chạy ở tần số tối đa 500 Hz và sử dụng đầy đủ cả 3 khâu P, I, D. Do con quay Gyroscope phản ứng tức thì không có độ trễ tích phân, tầng trong có khả năng dập tắt các rung lắc khí động học ngay lập tức trước khi góc máy bay kịp bị méo mó!

2.3 Các cơ chế bảo vệ chuyên sâu trong mã nguồn pid.ino

Khi đọc vào mã nguồn tại file CODE_FC/KyThuatUAV_FC_level_1/pid.ino, bạn sẽ thấy tác giả đã cài đặt các cơ chế bảo vệ rất chặt chẽ theo tiêu chuẩn hàng không:

1. Chống bão hòa tích phân (Anti-Windup): Khâu tích phân luôn bị chặn biên độ tuyệt đối qua hằng số I_LIM = 200.0f. Khi drone bị vật cản cơ học hoặc khi motor đã quay hết công suất trần, khâu I không bị cộng dồn lên đến vô cùng, ngăn ngừa việc drone lật nhào khi bất ngờ thoát tải.

2. Xả tích phân khi hạ ga (Bleed Integrators): Trong hàm pid_bleed_integrators(), khi cần ga bị kéo xuống đáy (u_throttle < 830), giá trị tích phân được nhân với hệ số 0.9 ở mỗi chu kỳ 2ms (tương đương xả sạch sau ~19ms). Cơ chế này ngăn chặn việc drone khi còn nằm dưới đất chờ cất cánh tự tích lũy sai số do mặt đất nghiêng để rồi nhảy chồm lên và lật úp khi vừa đẩy ga cất cánh!

3. Khâu tích phân một chiều cho độ cao (Climb PID): Trong hàm pid_step_climb(), khâu tích phân bị chặn không cho mang giá trị âm (st.integral < 0 -> = 0). Lý do vật lý: khâu I của trục thẳng đứng chính là lượng «Ga Treo Máy» (Hover Throttle) để thắng trọng lực Trái Đất — một đại lượng luôn dương.

CHƯƠNG 3: BỘ THÔNG SỐ MẶC ĐỊNH & PHÂN TÍCH KỸ THUẬT

Toàn bộ hệ số điều khiển nằm tập trung trong file KyThuatUAV_FC_level_1.ino. Đây là bộ thông số đã được bay thử và nghiệm thu thực tế trên cấu hình chuẩn: Khung carbon 5 inch chữ X, Động cơ 2204 2300KV, Cánh 5045, Pin LiPo 3S 2200mAh.

Kênh điều khiển | Kp | Ki | Kd | Giới hạn I | Giới hạn Out
Rate Roll (Nghiêng trái/phải) | 0.5 | 1.4 | 0.03 | ± 200 | ± 400
Rate Pitch (Chúi/ngửa mũi) | 0.5 | 1.4 | 0.03 | ± 200 | ± 400
Rate Yaw (Xoay hướng) | 1.0 | 10.0 | 0.00 | ± 100 | ± 100
Tilt Roll / Pitch (Tầng góc) | 10.0 | 0.0 | 0.00 | ± 200 | ± 400 °/s
Climb Rate (Leo/hạ độ cao) | 3.0 | 15.0 | 0.00 | 0 -> 700 | Kp chặn ±200

LƯU Ý KỸ THUẬT: TẠI SAO HỆ SỐ KD LẠI NHỎ (0.03)?
Theo tài liệu tự học (§9.2), cảm biến ICM-20602 kích hoạt bộ lọc thông thấp phần cứng DLPF ở tần số cắt 5.1 Hz để gạt bỏ nhiễu rung cơ học từ cánh quạt. Bộ lọc này làm suy giảm nhiễu tốt nhưng lại sinh ra ĐỘ TRỄ PHA khoảng 31 mili-giây. Chính độ trễ pha này là rào cản vật lý giới hạn biên độ của KD. Nếu nâng KD lên cao quá 0.05, độ trễ này sẽ kết hợp cùng nhiễu rung gây ra hiện tượng cộng hưởng tự kích, khiến 4 động cơ bị rít the thé và nóng ran sau vài giây bay.

CHƯƠNG 4: QUY TRÌNH TINH CHỈNH PID THỰC CHIẾN (TUNING GUIDE)

4.1 Quy tắc an toàn sống còn trước khi cân chỉnh

1. Luôn tháo cánh quạt (Props Off): Khi cắm cáp USB nạp code, cấu hình tham số trên bàn làm việc, tuyệt đối tháo cánh quạt. Động cơ Brushless quay không tải có thể đạt 20.000 - 30.000 vòng/phút, chém gãy cánh và gây sát thương sâu.

2. Buộc dây giới hạn (Tethering) cho lần bay đầu: Với người mới chưa có kinh nghiệm, hãy dùng 4 đoạn dây dù buộc chùng nối 4 chân đáp của drone xuống đất/cọc. Chiều dài dây chỉ đủ cho drone nhấc cao khỏi mặt đất 30 - 50 cm. Nếu drone có hiện tượng bị lộn nhào, dây sẽ ghì lại an toàn, cứu toàn bộ khung máy và linh kiện.

4.2 Trình tự cân chỉnh 3 bước chuẩn quốc tế

Nguyên tắc vàng khi chỉnh PID cho máy bay là chỉnh từng khâu một theo đúng thứ tự: P -> D -> I. Tuyệt đối không chỉnh đồng thời cả 3 hệ số vì bạn sẽ không thể biết dao động sinh ra do thành phần nào.

BƯỚC 1: Tinh chỉnh khâu P (Rate Roll / Pitch)

• Khởi tạo: Đặt Ki = 0 và Kd = 0. Giữ nguyên tầng góc Kp_tilt = 10.0.
• Thực hành: Cho drone cất cánh lơ lửng, gạt nhẹ cần lái Roll/Pitch rồi thả tay ra về vị trí giữa.
• Nhận diện hiện tượng:
- Nếu P quá thấp: Máy bay phản ứng lờ đờ, chòng chành bồng bềnh, cần lắc tay nhiều mới chịu nghiêng.
- Tăng dần P (mỗi lần tăng 0.05): Máy bay bắt đầu bám cần lái sát hơn, phản ứng nhanh nhạy.
- Khi P vượt ngưỡng tối ưu: Máy bay bắt đầu có hiện tượng RUNG GIẬT NHANH (Fast Oscillation) với tần số cao.
• Điểm chuẩn: Ngay khi phát hiện máy bay vừa chớm rung giật nhanh, hãy GIẢM Kp xuống khoảng 15% - 20%. Đây là giá trị P hoàn hảo.

BƯỚC 2: Tinh chỉnh khâu D (Rate Roll / Pitch)

• Khởi tạo: Giữ nguyên Kp vừa tìm được ở Bước 1. Vẫn giữ Ki = 0.
• Thực hành: Bắt đầu tăng dần Kd từ giá trị rất nhỏ (ví dụ: 0.01 -> 0.02 -> 0.03).
• Nhận diện hiện tượng:
- Khâu D đóng vai trò giảm xóc. Khi có D hợp lý, mỗi khi bạn gạt cần đổi hướng rồi thả tay, drone sẽ DỪNG KHỰNG LẠI DỨT KHOÁT, không hề có một chút nảy thừa (bounce-back) nào.
- DẤU HIỆU NGUY HIỂM: Nếu tăng Kd quá mức, bạn sẽ nghe thấy tiếng động cơ phát ra TIẾNG RÍT THE THÉ (High-pitch whine). Hạ cánh lập tức và sờ tay vào vỏ động cơ: nếu thấy MOTOR NÓNG RANG, khâu D đang khuếch đại nhiễu cơ học. Phải GIẢM Kd ngay lập tức về mức an toàn!

BƯỚC 3: Tinh chỉnh khâu I (Rate Roll / Pitch / Yaw)

• Khởi tạo: Giữ nguyên Kp và Kd đã tối ưu ở hai bước trước.
• Thực hành: Tăng Ki dần lên từ 0.5 -> 1.0 -> 1.4.
• Nhận diện hiện tượng:
- Khâu I chịu trách nhiệm «khóa cứng góc». Khi bay ngoài trời có gió thổi tạt ngang, hoặc khi trọng tâm pin bị lệch, khâu I sẽ sinh lực giữ cho máy bay nằm phẳng lì, không bị trôi nghiêng từ từ theo thời gian.
- Nếu Ki quá cao: Do tính trễ của tích phân, máy bay sẽ xuất hiện hiện tượng LẮC LƯ CHẬM BIÊN ĐỘ LỚN (Slow wobble, nhấp nhô như sóng biển). Khi thấy hiện tượng này, hãy giảm bớt Ki.

CHƯƠNG 5: BẢNG TRA CỨU «BẮT BỆNH» & XỬ LÝ SỰ CỐ BAY

Dưới đây là cẩm nang tổng hợp nhanh các lỗi bay thực tế thường gặp và hướng can thiệp trực tiếp vào mã nguồn firmware:

Hiện tượng quan sát thực tế | Nguyên nhân gốc rễ | Cách khắc phục chính xác
Động cơ phát tiếng rít the thé, motor nóng ran sau vài chục giây bay | Khâu vi phân D quá lớn, khuếch đại nhiễu rung từ cánh quạt vào xung ESC. | Giảm ngay KD_RATE_ROLL và KD_RATE_PITCH trong KyThuatUAV_FC_level_1.ino (ví dụ từ 0.03 về 0.015 - 0.02).
Máy bay bị rung lắc giật cục tần số cao liên tục khi cất cánh | Khâu tỉ lệ P của tầng tốc độ góc quá cao, gây dao động tự kích. | Giảm KP_RATE_ROLL và KP_RATE_PITCH xuống 20 - 30%.
Máy bay chòng chành, lắc lư chậm chạp biên độ lớn (nhấp nhô) | Hệ thống bị dư thừa phản hồi tích phân I hoặc P quá lớn so với tải trọng. | Giảm KP_RATE trước; nếu vẫn còn lắc thì giảm tiếp KI_RATE_ROLL và KI_RATE_PITCH.
Thả cần gạt về giữa nhưng máy bay bị trôi nghiêng lệch sang một bên | 1. Gia tốc kế chưa được bù sai số tĩnh (ACC_OFFSET). 2. Hoặc tầng góc P quá yếu. | 1. Bật CALIBRATE_ACCEL đo lại và dán đúng 3 dòng ACC_OFFSET_*. 2. Tăng nhẹ KP_TILT_ROLL / KP_TILT_PITCH (từ 10 lên 12 - 14).
Nâng cấp sang khung to hơn (ví dụ khung 7 - 10 inch, cánh 9 - 10 inch) | Khung lớn và motor nặng có quán tính cơ học cao, tốc độ đáp ứng tự nhiên chậm hơn khung 5 inch. | Bắt buộc phải GIẢM KP_RATE_ROLL và KP_RATE_PITCH. Giữ nguyên hệ số cũ của khung 5 inch sẽ làm khung lớn rung giật dữ dội.

LỜI KẾT & CHÚC THÀNH CÔNG
Lập trình và cân chỉnh bộ điều khiển bay PID là một trong những trải nghiệm học tập và nghiên cứu kỹ thuật hấp dẫn nhất của ngành Cơ điện tử & Hàng không. Một khi bạn đã nắm vững bản chất vật lý của từng khâu P, I, D và cách các vòng lặp phản hồi tương tác với nhau trên nền tảng nhúng thời gian thực ESP32, bạn đã sở hữu chìa khóa để làm chủ hoàn toàn mọi loại phương tiện bay tự hành.

Kỹ Thuật UAV — Cẩm Nang Lập Trình & Điều Khiển PID Drone ESP32
