3XChehe/project-3/ESP32_FC/Tài liệu kèm theo/TAI_LIEU_TU_HOC.docx

# TÀI LIỆU TỰ HỌC

## Bộ điều khiển bay KyThuatUAV FC — nền tảng ESP32

Tác giả: Nguyễn Văn Quý (Kỹ Thuật UAV)

Đối tượng phân tích: CODE_FC/KyThuatUAV_FC_level_1, 1811 dòng, 9 đơn vị biên dịch

Phiên bản trình biên dịch tham chiếu: Arduino ESP32 core 2.0.17, FQBN esp32:esp32:esp32da

## 0. Phạm vi, giả thiết và quy ước ký hiệu

### 0.1 Phạm vi

Tài liệu phân tích cấu trúc và đặc tính định lượng của phần mềm điều khiển bay

cho phương tiện bay không người lái bốn cánh quạt cấu hình chữ X. Phân tích giới

hạn ở lớp phần mềm nhúng; các vấn đề khí động lực học, mô hình hoá lực đẩy và

nhận dạng tham số khung máy nằm ngoài phạm vi.

### 0.2 Giả thiết

- G1. Cảm biến quán tính gắn cứng vào khung, trục cảm biến trùng trục thân

máy, sai lệch lắp đặt được xem là nhỏ và đã bù bằng hằng số tĩnh.

- G2. Góc nghiêng vận hành nhỏ, cho phép xấp xỉ tuyến tính hoá quanh trạng

thái treo.

- G3. Bốn cơ cấu chấp hành đồng nhất về đặc tính lực đẩy theo tín hiệu điều

khiển; hệ không bù phi tuyến lực đẩy và không bù sụt áp nguồn.

- G4. Nhiễu đo của gia tốc kế và áp kế được mô hình hoá là nhiễu trắng Gauss

không tương quan, kỳ vọng bằng không.

Giả thiết G4 bị vi phạm trong thực tế: nhiễu rung do cánh quạt là nhiễu có màu,

tập trung phổ quanh tần số quay. Hệ quả được thảo luận ở §9.2.

### 0.3 Quy ước ký hiệu

Ký hiệu | Ý nghĩa | Đơn vị
Tₛ | chu kỳ lấy mẫu vòng điều khiển | s
φ, θ | góc nghiêng trục dọc (roll), trục ngang (pitch) | độ
p, q, r | tốc độ góc thân máy quanh ba trục | độ/s
a_x, a_y, a_z | gia tốc đo trong hệ thân máy | g
a_z^(E) | gia tốc thẳng đứng trong hệ quy chiếu mặt đất, đã trừ trọng trường | g
z, ż | độ cao và tốc độ biến thiên độ cao | cm, cm/s
u_φ, u_θ, u_ψ | tín hiệu điều khiển ba trục quay | đơn vị mixer
(·)^(sp) | giá trị đặt (setpoint) | —

Quy ước đặt tên trong mã nguồn mang đơn vị ngay trong định danh (_deg, _dps,

_cm, _cms, _g), nhằm loại trừ nhóm lỗi sai đơn vị tại các điểm ghép nối

giữa mô-đun. Điểm ghép nối áp kế – bộ lọc Kalman (mét sang xen-ti-mét) là ví dụ

điển hình cho lớp lỗi này.

## 1. Kiến trúc phần mềm thời gian thực

### 1.1 Phân rã tác vụ

Hệ thống được phân rã thành ba tác vụ FreeRTOS chạy trên hai nhân xử lý của

SoC ESP32:

Tác vụ | Nhân | Chu kỳ | Ưu tiên | Kích thước ngăn xếp
control_task | 1 | 2 ms (500 Hz) | 5 | 8192 B
rc_task | 0 | 2 ms (500 Hz) | 4 | 3072 B
baro_task | 0 | 10 ms (100 Hz) | 2 | 4096 B

Nhân 1 được dành riêng cho vòng điều khiển. Quyết định này loại bỏ hoàn toàn

tranh chấp CPU giữa vòng điều khiển và các tác vụ ngoại vi, đổi lấy việc không

tận dụng hết năng lực tính toán của nhân đó. Với hệ có ràng buộc thời gian

cứng, đây là đánh đổi hợp lý: độ tin cậy về định thời quan trọng hơn hiệu suất

sử dụng tài nguyên.

Tác vụ loop() mặc định của khung Arduino bị huỷ bằng vTaskDelete(NULL) ở

cuối setup(), giải phóng ngăn xếp của nó.

### 1.2 Cơ chế giữ nhịp

Cả ba tác vụ dùng vTaskDelayUntil() thay vì vTaskDelay(). Khác biệt có ý

nghĩa: vTaskDelayUntil() tính thời điểm đánh thức từ mốc tuyệt đối của lần

trước, nên sai số thực thi của một chu kỳ không tích luỹ sang chu kỳ sau. Với

vTaskDelay(), chu kỳ thực tế sẽ là Tₛ + δᵢ với δᵢ là thời

gian thực thi thân vòng lặp, và sai số cộng dồn không giới hạn.

Chu kỳ thực đo được ghi vào loop_period_us mỗi vòng và có thể quan sát qua

cờ biên dịch DEBUG_LOOP_TIME. Giá trị kỳ vọng là 2000 µs.

### 1.3 Mô hình đồng bộ hoá và nhất quán dữ liệu

Dữ liệu chia sẻ giữa các tác vụ được bảo vệ bằng ba mutex độc lập, phân theo

nhóm dữ liệu chứ không dùng một khoá toàn cục:

Mutex | Bảo vệ | Chiều ghi → đọc
mtx_rc | shared_rc_ch[17], shared_rc_ok | rc_task → control_task
mtx_baro | shared_baro_alt_m | baro_task → control_task
mtx_tlm | khối tlm_* | control_task → baro_task

Việc tách khoá theo nhóm loại bỏ phụ thuộc giả (false dependency) giữa các luồng

dữ liệu không liên quan: tác vụ áp kế và tác vụ RC không bao giờ chặn lẫn nhau.

Chính sách lấy khoá. Mọi lời gọi xSemaphoreTake() đều dùng thời gian chờ

bằng không:

if (xSemaphoreTake(mtx_rc, 0) == pdTRUE) { ... }

Nếu không lấy được khoá, tác vụ không chờ mà tiếp tục với dữ liệu của chu kỳ

trước. Đây là quyết định thiết kế có chủ đích: vòng điều khiển không bao giờ

được phép bị chặn. Cái giá là dữ liệu có thể cũ, nhưng độ cũ bị chặn trên bởi

đúng một chu kỳ ghi (2 ms với RC, 10 ms với áp kế) — nhỏ hơn nhiều so với hằng

số thời gian của mọi vòng điều khiển trong hệ.

Mô hình đệm kép. Tác vụ ghi chép dữ liệu vào vùng shared_* dưới khoá; tác

vụ đọc sao chép sang biến cục bộ cũng dưới khoá, rồi thao tác trên bản sao. Nhờ

đó mỗi chu kỳ điều khiển làm việc trên một ảnh chụp nhất quán về thời gian, thay

vì đọc từng trường rời rạc có thể thuộc hai thời điểm khác nhau.

Khối telemetry đi theo chiều ngược lại và áp dụng cùng nguyên tắc: vòng điều

khiển chỉ chụp trạng thái vào tlm_*; toàn bộ chi phí định dạng và truyền

chuỗi do baro_task ở nhân 0 gánh. Không có lệnh xuất Serial nào nằm trong đường điều khiển. Đây là ràng buộc kiến trúc, không phải quy ước phong cách:

ở 500 Hz, một lời gọi Serial.print() bị chặn do đầy bộ đệm truyền sẽ kéo dài

chu kỳ và làm sai lệch mọi phép tích phân, vi phân dùng Tₛ hằng số.

### 1.4 Phân tích khả thi lịch biểu

Xét nhân 0 mang hai tác vụ. Đặt Cᵢ là thời gian thực thi xấu nhất, Tᵢ là

chu kỳ. Tiêu chuẩn Liu–Layland cho lịch biểu ưu tiên đơn điệu theo tần số với

n tác vụ:

U = Σ_i=1^(n) Cᵢ/Tᵢ ≤ n(2^(1/n) - 1)

Với n = 2, ngưỡng là 0,828. Ước lượng thành phần:

- rc_task: đọc bộ đệm UART và giải mã tối đa 25 byte, C ≲ 60 µs trên

T = 2 ms, đóng góp U ≈ 0,030.

- baro_task: một giao dịch I²C 7 byte ở 400 kHz chiếm khoảng 175 µs kể cả

điều kiện khởi động và địa chỉ; cộng phần bù nhiệt-áp dùng số thực độ chính

xác kép, ước tính C ≲ 400 µs trên T = 10 ms, đóng góp

U ≈ 0,040.

Tổng U ≈ 0,07, thấp hơn ngưỡng một bậc độ lớn. Nhân 0 còn dư năng lực

đáng kể; đây là chỗ có thể tiếp nhận thêm cảm biến mà không cần tái thiết kế.

Nhân 1 chỉ có một tác vụ nên điều kiện khả thi rút gọn thành C ≤ T. Ước

lượng thành phần chi phối ở §9.1.

## 2. Phân hệ cảm biến quán tính

### 2.1 Giao tiếp và cấu hình

Cảm biến ICM-20602 giao tiếp qua SPI ở 10 MHz, chế độ 0, truy cập trực tiếp

thanh ghi. Không sử dụng thư viện trung gian. Quyết định này loại bỏ phụ thuộc

phiên bản thư viện và cho phép kiểm soát chính xác trình tự khởi tạo, nhưng

chuyển gánh nặng đúng đắn sang người viết.

Thanh ghi | Giá trị | Ý nghĩa
PWR_MGMT_1 (0x6B) | 0x00 | thoát chế độ ngủ
ACCEL_CONFIG (0x1C) | 0x18 | thang đo gia tốc ±16 g
GYRO_CONFIG (0x1B) | 0x18 | thang đo con quay ±2000 °/s
CONFIG (0x1A) | 0x06 | DLPF con quay, băng thông 5,1 Hz
ACCEL_CONFIG2 (0x1D) | 0x05 | DLPF gia tốc kế, băng thông 10 Hz

Tính hiện diện của cảm biến được kiểm chứng qua thanh ghi WHO_AM_I (0x75) với

giá trị kỳ vọng 0x12, trước khi thực hiện hiệu chỉnh. Trình tự này là bắt

buộc: nếu cảm biến không phản hồi, bus SPI trả về giá trị hằng, hai lô mẫu liên

tiếp trong vòng hiệu chỉnh sẽ giống hệt nhau, và điều kiện hội tụ được thoả mãn

một cách sai lầm với độ lệch vô nghĩa. Khi không phát hiện được cảm biến, hệ

thống dừng vô hạn và nhấp nháy đèn báo thay vì tiếp tục khởi động.

### 2.2 Lượng tử hoá

Bộ biến đổi 16 bit trên hai thang đo đã chọn cho độ phân giải:

Δ_ω = 1/(16,4) ≈ 6,10 × 10⁻² °/s, Δₐ = 1/2048 ≈ 4,88 × 10⁻⁴ g

Sai số lượng tử hoá gia tốc kế truyền sang góc suy ra từ gia tốc. Tuyến tính hoá

quanh trạng thái nằm ngang, với φ = arctan(a_y/√(a_x²+a_z²)):

(∂ φ)/(∂ a_y)|_φ=0 = 1 rad/g ⟹ δφ ≈ Δₐ · 180/π ≈ 0,028°

Độ phân giải góc do lượng tử hoá là 0,028°, nhỏ hơn hai bậc so với nhiễu

rung cơ khí trong điều kiện bay thực. Kết luận: lượng tử hoá không phải là nguồn sai số chi phối; việc chọn thang đo rộng (±16 g, ±2000 °/s) để tránh bão

hoà là đánh đổi đúng.

### 2.3 Hiệu chỉnh độ lệch con quay

Thuật toán hiệu chỉnh không lấy trung bình một lô cố định rồi chấp nhận kết quả.

Thay vào đó nó lặp cho tới khi phát hiện phương tiện thực sự đứng yên:

Lô thứ k: Sₖ = Σ_i=1^(N) ωᵢ, N = 500

Điều kiện dừng, áp đồng thời cho ba trục:

|Sₖ - S_k-1| < Λ, Λ = 40

Chuyển ngưỡng về đơn vị vật lý: Λ/N = 40/500 = 0,08 °/s là chênh lệch

trung bình cho phép giữa hai lô liên tiếp. Ngưỡng này độc lập với thang đo vì

Sₖ được tích luỹ sau khi đã quy đổi sang °/s.

Lập luận về tính đúng đắn. Phương pháp lô đơn có lỗ hổng: nếu phương tiện

đang chuyển động trong lúc lấy mẫu, chuyển động đó bị hấp thụ vào ước lượng độ

lệch. Độ lệch sai làm bộ điều khiển hiểu nhầm phương tiện đang quay khi nó đứng

yên, sinh ra mô-men hiệu chỉnh thường trực và gây trôi ngay từ thời điểm cất

cánh. Điều kiện dừng dựa trên tính lặp lại giữa hai lô phát hiện được tình

huống này, vì chuyển động ngẫu nhiên không cho hai tổng liên tiếp gần nhau.

Cái giá là thời gian hiệu chỉnh không xác định trước. Trong bối cảnh khởi động

mặt đất, đây là đánh đổi chấp nhận được.

### 2.4 Bù độ lệch gia tốc kế

Ba hằng số ACC_OFFSET_*_G được cộng vào số đo thô. Quy trình xác định chúng

được thực hiện bởi khối imu_calibrate_accel(), biên dịch có điều kiện qua

CALIBRATE_ACCEL, lấy trung bình 2000 mẫu ở tư thế nằm ngang và in ra trực tiếp

ba dòng khai báo cần dán vào mã nguồn.

Chế độ này có hai kiểm tra tư thế trước khi tin kết quả: a_z ≥ 0,80 g

loại trừ trường hợp lật ngược hoặc dựng nghiêng, và | a_x|, | a_y| ≤ 0,30 g loại trừ mặt phẳng đặt không ngang hoặc cảm biến gắn lệch. Trường hợp

thứ hai cần sửa cơ khí, không được bù bằng phần mềm.

Sau khi đo xong, hàm không trả về mà dừng vô hạn. Hệ quả là các tác vụ điều

khiển không bao giờ được tạo, nên không thể bay ở chế độ hiệu chỉnh. Điều

này quan sát được qua kích thước ảnh nhị phân: bản có CALIBRATE_ACCEL chiếm

21% bộ nhớ chương trình so với 23% của bản thường, do trình tối ưu loại bỏ được

toàn bộ nhánh không tới được.

## 3. Phân hệ áp kế

### 3.1 Ràng buộc định thời giữa ODR và OSR

BMP388 được cấu hình qua thanh ghi, không dùng thư viện. Thời gian một chu kỳ đo

theo datasheet Bosch, mục 3.9.2:

t_meas = 234 + (392 + 2^(osr_p) · 2020) + (163 + 2^(osr_t) · 2020) [µs]

Với cấu hình đang dùng, osr_p = 3 (bội 8) và osr_t = 0 (bội 1):

t_meas = 234 + 16552 + 2183 = 18969 µs = 18,97 ms

Chu kỳ ở ODR 50 Hz là 20 ms, biên an toàn 1,03 ms tương đương 5,2%.

Cặp tham số nằm sát ràng buộc nhưng thoả mãn. Nếu tăng ODR mà giữ nguyên OSR,

cảm biến không hoàn thành phép đo kịp chu kỳ và tự báo lỗi conf_err ở bit 2

thanh ghi ERR; mã nguồn kiểm tra và báo lỗi này tường minh khi khởi tạo.

Lựa chọn OSR bội 8 thay vì bội 1 đánh đổi tốc độ lấy nhiều mẫu để giảm nhiễu áp

suất. Với ứng dụng giữ độ cao, nhiễu áp suất là đại lượng chi phối chất lượng

điều khiển, còn 50 Hz đã dư so với băng thông vòng độ cao (§5.4).

### 3.2 Cổng dữ liệu theo cờ sẵn sàng

baro_task chạy ở 100 Hz trong khi cảm biến chỉ sinh mẫu ở 50 Hz. Hàm

baro_update() đọc gộp thanh ghi STATUS (0x03) cùng sáu byte dữ liệu (0x04–0x09)

trong một giao dịch I²C, và chỉ chấp nhận số liệu khi bit drdy_press được đặt.

Bỏ qua kiểm tra này gây hệ quả tinh vi: cùng một mẫu bị đọc hai lần và nạp vào

bộ lọc Kalman như hai phép đo độc lập. Bộ lọc khi đó thu hẹp hiệp phương sai sai

số ước lượng nhanh gấp đôi mức chính đáng — nghĩa là nó trở nên tự tin sai cách, và bám nhiễu áp kế thay vì lọc nhiễu. Lỗi thuộc loại không sinh triệu

chứng rõ ràng và rất khó truy ngược từ hiện tượng bay.

### 3.3 Bù nhiệt–áp và quy đổi độ cao

Hai mươi mốt byte hệ số hiệu chỉnh riêng của từng chip được đọc từ thanh ghi

CALIB (0x31) và giải mã theo đúng thang chia của datasheet. Đa thức bù được

tính bằng số thực độ chính xác kép: các hệ số P_9, P_10, P_11 có thang

chia tới 2^(48) và 2^(65), vượt quá dải biểu diễn hữu ích của số thực độ

chính xác đơn.

Quy đổi áp suất sang độ cao dùng công thức khí quyển tiêu chuẩn:

h = 44330 [1 - (p/p₀)^(0,1902949571836346)] [m], p₀ = 101325 Pa

Số mũ là R L / (g M) của mô hình ISA tầng đối lưu. Độ cao tuyệt đối này chỉ

đúng khi áp suất mực nước biển thực tế bằng p₀; hệ thống không hiệu chỉnh

theo QNH. Điều đó không ảnh hưởng chức năng vì đại lượng dùng cho điều khiển là

độ cao tương đối so với mốc đo lúc khởi động:

h_rel = h - h_ref

với h_ref lấy trung bình 50 mẫu hợp lệ trong baro_measure_reference().

Sai số hệ thống do p₀ sai bị triệt tiêu trong phép trừ.

## 4. Ước lượng trạng thái

### 4.1 Ước lượng góc nghiêng — bộ lọc Kalman vô hướng

Với mỗi trục nghiêng, mô hình trạng thái một chiều:

φₖ⁻ = φ_k-1⁺ + Tₛ ωₖ, Pₖ⁻ = P_k-1⁺ + Tₛ² σ_w²

Kₖ = Pₖ⁻/(Pₖ⁻ + σ_v²), φₖ⁺ = φₖ⁻ + Kₖ(φₖ^(acc) - φₖ⁻), Pₖ⁺ = (1 - Kₖ) Pₖ⁻

Tham số đang dùng: σ_w = 1 °/s (nhiễu quá trình, tức độ bất định của tốc

độ góc), σ_v = 3° (nhiễu đo của góc suy từ gia tốc kế), Tₛ = 0,002 s.

Nghiệm dừng. Đặt q = Tₛ²σ_w² = 4×10⁻⁶ và R = σ_v² = 9.

Ở trạng thái dừng, P⁺ = P⁻ - q và phương trình Riccati rời rạc rút gọn

thành

x² - qx - qR = 0, x ≡ P⁻

Vì q ≪ R, nghiệm dương xấp xỉ x ≈ √(qR), cho độ lợi dừng

K∞ ≈ √(q/R) = √((4×10⁻⁶)/9) ≈ 6,67×10⁻⁴

Diễn giải. Bộ lọc Kalman vô hướng với độ lợi dừng tương đương một bộ lọc bù

(complementary filter) có hằng số thời gian

τ = Tₛ/K∞ ≈ (0,002)/(6,67×10⁻⁴) ≈ 3,0 s

Nghĩa là: thành phần góc từ gia tốc kế được hoà vào ước lượng với hằng số thời gian khoảng ba giây; trong khung thời gian ngắn hơn, ước lượng do con quay chi phối hoàn toàn. Đây là đặc tính mong muốn — gia tốc kế trong lúc cơ động đo cả

gia tốc chuyển động lẫn trọng trường, nên góc suy ra từ nó chỉ đáng tin ở trung

bình dài hạn.

Hạn chế. Mô hình đo giả định gia tốc kế chỉ cảm nhận trọng trường (giả thiết

G4 mở rộng). Trong cơ động kéo dài quá vài giây theo một hướng, giả định này sai

và ước lượng góc lệch dần.

Sai lệch này không loại bỏ được trong khuôn khổ một bộ lọc vô hướng chỉ có hai nguồn tin là con quay và gia tốc kế. Lý do mang tính nguyên tắc: gia tốc kế đo

tổng của trọng trường và gia tốc chuyển động, mà từ một phép đo tổng thì không

tách được hai thành phần nếu không có thông tin độc lập về một trong hai. Việc

chọn τ ≈ 3 s chỉ làm chậm quá trình lệch, không ngăn được nó.

### 4.2 Chiếu gia tốc về hệ quy chiếu mặt đất

Thành phần thẳng đứng của gia tốc trong hệ mặt đất, đã trừ trọng trường:

a_z^(E) = -sinθ · a_x + cosθ sinφ · a_y + cosθ cosφ · a_z - 1

Đây là hàng thứ ba của ma trận cosin chỉ phương từ hệ thân sang hệ mặt đất, áp

lên véc-tơ gia tốc đo. Phép chiếu chỉ cần hai góc nghiêng, không cần góc

hướng, vì trục thẳng đứng bất biến với phép quay quanh chính nó. Hệ quả thiết

kế: bậc này không cần bộ lọc quaternion (Madgwick, Mahony) cũng như không cần từ

kế.

### 4.3 Ước lượng độ cao — bộ lọc Kalman hai trạng thái

Véc-tơ trạng thái x = [z, ż]^ᵀ, mô hình gia tốc là đầu vào

điều khiển:

F = [1, Tₛ; 0, 1], G = [Tₛ²/2; Tₛ], H = [1, 0]

Q = GG^ᵀ σₐ², R = σ_z²

Tham số: σₐ = 4 cm/s², σ_z = 30 cm.

Chu trình đầy đủ mỗi bước:

x⁻ = Fx⁺ + Gu, P⁻ = FP⁺F^ᵀ + Q

S = HP⁻H^ᵀ + R, K = P⁻H^ᵀ S⁻¹

x⁺ = x⁻ + K(z^(meas) - Hx⁻), P⁺ = (I - KH)P⁻

Về phép nghịch đảo. S là ma trận 1×1, nên nghịch đảo của nó là

nghịch đảo số học. Mã nguồn khai thác điều này thay vì gọi hàm nghịch đảo ma

trận tổng quát, kèm chốt chặn S > 10⁻⁶. Ngoài lợi ích tốc độ, cách viết này

độc lập với phiên bản thư viện: BasicLinearAlgebra phiên bản 3.x cung cấp

Invert() trả về ma trận, còn từ 4.x hàm cùng tên nghịch đảo tại chỗ và trả về

kiểu logic — mã viết theo cú pháp cũ không biên dịch được trên bản mới.

Nghiệm dừng. Chỉ số bám (tracking index) của bộ lọc α–β tương đương:

Λ = (σₐ Tₛ²)/(σ_z) = (4 · (0,002)²)/30 ≈ 5,33×10⁻⁷

r = (4 + Λ - √(8Λ + Λ²))/4 ≈ 0,999484

α = 1 - r² ≈ 1,03×10⁻³, β = 2(1-r)² ≈ 5,33×10⁻⁷

Hằng số thời gian của thành phần vị trí:

τ_z = Tₛ/α ≈ (0,002)/(1,03×10⁻³) ≈ 1,94 s

Ước lượng độ cao bám theo áp kế với hằng số thời gian khoảng hai giây; trong khung ngắn hơn, tốc độ thẳng đứng do tích phân gia tốc chi phối.

### 4.4 Ràng buộc nhịp giữa dự đoán và hiệu chỉnh

Đây là điểm thiết kế dễ bị hiểu sai nhất trong toàn hệ và được ghi chú tường

minh trong mã nguồn.

Bộ lọc chạy cả bước dự đoán lẫn bước hiệu chỉnh ở mỗi chu kỳ 500 Hz, kể cả

khi áp kế chưa sinh mẫu mới — tức cùng một giá trị đo được nạp lại nhiều lần.

Xét theo lý thuyết ước lượng thuần tuý, đây là sai: nạp lại một phép đo như phép

đo độc lập làm bộ lọc đánh giá quá cao lượng thông tin nhận được. Tuy nhiên bộ

tham số (σₐ, σ_z) được xác định cùng với nhịp hiệu chỉnh này.

Với α ≈ 10⁻³, mỗi bước hiệu chỉnh đơn lẻ gần như không dịch

chuyển ước lượng; hiệu quả kéo về chỉ hình thành nhờ được áp dụng 500 lần mỗi

giây.

Thực nghiệm đã xác nhận: khi chuyển sang cổng hiệu chỉnh theo cờ dữ liệu mới

(~50 Hz) mà giữ nguyên tham số, hệ mất chín phần mười số bước hiệu chỉnh trong

khi độ lợi vẫn ở mức cũ. Thành phần kéo về gần như biến mất và ước lượng tốc độ

thẳng đứng suy biến thành tích phân gia tốc thuần, trôi không giới hạn.

Kết luận về tính đúng đắn. Cặp (cấu trúc bộ lọc, bộ tham số) là một chỉnh

thể; không được thay đổi riêng một thành phần. Muốn chuyển sang sơ đồ hiệu chỉnh

theo sự kiện, phải tăng σₐ tương ứng — bậc độ lớn khoảng √(10) khi

giảm mười lần số nhịp — và thẩm định lại bằng bay thử.

## 5. Luật điều khiển

### 5.1 Cấu trúc phân tầng

φ^(sp) --[ PID góc ]--> p^(sp) --[ PID tốc độ góc ]--> u_φ --[ mixer ]--> ESC

ż^(sp) --[ PID tốc độ thẳng đứng ]--> u_throttle

Nguyên tắc phân tầng: đầu ra của tầng ngoài là giá trị đặt của tầng trong, và

giới hạn đầu ra tầng ngoài chính là giới hạn đầu vào tầng trong. Điều này bảo

đảm tầng trong không bao giờ nhận giá trị đặt nằm ngoài khả năng theo dõi.

Tầng | K_P | K_I | K_D | Chặn tích phân | Chặn đầu ra
Góc roll / pitch | 10,0 | 0 | 0 | 200 | 400 °/s
Tốc độ góc roll / pitch | 0,5 | 1,4 | 0,03 | 200 | 400
Tốc độ góc yaw | 1,0 | 10,0 | 0 | 100 | 100
Tốc độ thẳng đứng | 3,0 | 15,0 | 0 | 700 | 200 (chặn riêng khâu P)

Tầng góc chỉ dùng khâu tỉ lệ. Lựa chọn này nhất quán với thực hành trong

ArduPilot (AC_AttitudeControl dùng AC_P) và PX4: sai số tích luỹ của vòng

góc được xử lý bởi khâu tích phân của vòng tốc độ góc, thêm tích phân ở cả hai

tầng dễ gây tương tác động học không mong muốn.

### 5.2 Rời rạc hoá

uₖ = K_P eₖ + K_I Σⱼ ((eⱼ + e_j-1)Tₛ)/2 [hình thang] + K_D (eₖ - e_k-1)/Tₛ [sai phân lùi]

Tích phân dùng quy tắc hình thang thay vì tổng Riemann trái. Với tín hiệu biến

thiên chậm so với Tₛ, sai số tích phân giảm từ bậc O(Tₛ) xuống

O(Tₛ²).

Đặc điểm cần lưu ý. Khâu vi phân lấy sai phân trên sai số, không phải

trên đại lượng đo. Hệ quả là mỗi lần giá trị đặt thay đổi bậc thang, khâu D sinh

xung lớn (derivative kick). Ở bậc này ảnh hưởng bị giới hạn bởi hai yếu tố: giá

trị đặt đã qua bộ lọc bậc nhất ở §7.3 nên không có bước nhảy thật sự, và

K_D = 0,03 tương đối nhỏ. Với hệ số D lớn hơn, nên chuyển sang lấy vi phân

trên đại lượng đo.

Không có bộ lọc thông thấp trên khâu D. Đây là khác biệt so với AC_PID của

ArduPilot (tham số FLTD, mặc định 20 Hz cho Copter) và là hạn chế đã biết —

xem §10.

### 5.3 Chống bão hoà tích phân

Cơ chế là kẹp biên độ tuyệt đối: |I| ≤ I_lim sau mỗi lần cộng dồn. Đây là

phương pháp đơn giản nhất trong họ chống windup, không phải phương pháp tốt

nhất — nó không phân biệt trường hợp đầu ra đang bão hoà với trường hợp tích

phân đang được kéo về không.

Bổ sung hai cơ chế xả:

- pid_reset_all() đặt mọi tích phân về không khi mất trạng thái arm.
- pid_bleed_integrators() nhân tích phân với hệ số 0,9 mỗi chu kỳ khi cần

ga xuống dưới ngưỡng 830, tương đương hằng số thời gian xả

τ = -Tₛ/ln 0,9 ≈ 19 ms. Mục đích: khi phương tiện còn trên mặt

đất và bị giữ nghiêng, tích phân không tích luỹ để rồi phóng ra lúc cất cánh.

### 5.4 Vòng tốc độ thẳng đứng

Vòng này có hai khác biệt so với các vòng khác, cả hai đều có căn cứ vật lý:

Khâu tích phân bị chặn một phía, I ≥ 0. Khâu tích phân của vòng này

chính là lượng ga treo máy — đại lượng luôn dương. Cho phép nó âm là cho phép bộ

điều khiển đề xuất lực đẩy âm, vô nghĩa với cơ cấu một chiều quay.

Khâu tỉ lệ bị chặn riêng ở ± 200. Ước lượng tốc độ thẳng đứng chịu ảnh

hưởng nhiễu áp kế. Không chặn riêng khâu P thì một xung nhiễu áp suất sẽ truyền

thẳng thành xung ga. Chặn tại khâu P giữ nguyên khả năng của khâu I trong việc

gánh ga treo máy.

Đầu ra không chặn đối xứng như các vòng khác, vì nó được cộng vào ESC_IDLE rồi

mới đưa qua khâu giới hạn cuối cùng ở §6.2.

### 5.5 Ma trận phân phối

[m_1; m_2; m_3; m_4] = u_th1 + [-1, -1, -1; +1, +1, -1; +1, -1, +1; -1, +1, +1] [u_φ; u_θ; u_ψ]

Cấu hình chữ X tiêu chuẩn. Cột thứ ba mã hoá chiều quay: động cơ 1 và 4 quay

cùng chiều, 2 và 3 quay chiều ngược lại, nên mô-men phản lực quanh trục đứng

triệt tiêu ở trạng thái cân bằng.

Ma trận có hạng 3 trên không gian bốn đầu ra: tồn tại một chiều tự do không được

điều khiển, chính là thành phần đồng pha u_th.

## 6. Cơ cấu chấp hành

### 6.1 Ánh xạ tín hiệu

Ngoại vi LEDC của ESP32 phát xung với tần số 391 Hz và độ phân giải 11 bit.

Chu kỳ và bước lượng tử:

T_pwm = 1/391 = 2557,5 µs, Δ_pwm = (2557,5)/(2^(11)) = 1,2488 µs/đơn vị

Kiểm chứng hai đầu dải làm việc:

Giá trị đếm | Độ rộng xung | Ý nghĩa
800 | 800 × 1,2488 = 999,0 µs | ngưỡng dưới chuẩn ESC
1600 | 1600 × 1,2488 = 1998,1 µs | ngưỡng trên chuẩn ESC

Cặp tham số (391 Hz, 11 bit) được chọn sao cho ánh xạ từ giá trị đếm sang micro

giây gần như tỉ lệ 1 : 1,25, đưa dải làm việc 800–1600 trùng khớp chuẩn PWM

1000–2000 µs với sai lệch dưới 0,1%. Độ phân giải lực đẩy là 1,25 µs trên

dải 1000 µs, tức khoảng 800 mức — dư so với yêu cầu.

### 6.2 Giới hạn và trạng thái an toàn

Trạng thái | Cận dưới | Cận trên
Chưa arm | 800 | 800
Đã arm | 900 | 1600

Cận dưới 900 khi đã arm bảo đảm động cơ không dừng hẳn giữa không trung. Động cơ

dừng rồi khởi động lại có độ trễ đáng kể và không đồng đều giữa bốn nhánh, gây

mất điều khiển tạm thời.

Ngoài khâu kẹp, còn một chốt chặn tường minh: khi armed sai, bốn giá trị bị ghi

đè bằng ESC_IDLE bất kể kết quả tính toán phía trước. Đây là dư thừa có chủ ý —

một tầng bảo vệ không phụ thuộc vào tính đúng đắn của các cận.

## 7. Giao diện điều khiển từ xa

### 7.1 Lớp vật lý

SBUS là giao thức nối tiếp không đồng bộ, 100 000 baud, khung 8E2 (8 bit dữ

liệu, 1 bit chẵn lẻ chẵn, 2 bit dừng), mức logic đảo.

UART của ESP32 đảo tín hiệu bằng phần cứng, kích hoạt bằng tham số thứ năm của

begin(). Nhờ đó không cần mạch đảo ngoài — khác với nhiều nền tảng phải bổ

sung transistor.

Thời lượng một khung:

t_frame = (25 byte × 12 bit)/100000 = 3,0 ms

### 7.2 Giải mã và kiểm tra tính toàn vẹn

Mười sáu kênh mã hoá liên tục 11 bit mỗi kênh, không theo biên byte. Vòng

giải mã dịch bit tuần tự qua 22 byte tải.

Khung được chấp nhận khi thoả đồng thời ba điều kiện: độ dài đúng 25 byte, byte

đầu bằng 0x0F, byte cuối bằng 0x00. Sai bất kỳ điều kiện nào thì bỏ toàn bộ

khung. Đây không phải kiểm tra mã dư vòng nên không phát hiện được mọi lỗi bit,

nhưng đủ để loại các khung lệch đồng bộ — dạng lỗi phổ biến nhất trên đường

truyền nối tiếp.

Ánh xạ tuyến tính từ giá trị thô sang dải quy ước:

u_µs = 990 + (v_raw - 173)·(2010 - 990)/(1811 - 173)

### 7.3 Định hình lệnh

Lệnh cần gạt qua bộ lọc thông thấp bậc nhất, a = 0,05 ở 500 Hz:

yₖ = (1-a)y_k-1 + a xₖ

Hằng số thời gian và tần số cắt tương đương:

τ = (Tₛ(1-a))/a ≈ 38 ms, f_c = 1/(2πτ) ≈ 4,2 Hz

Băng thông này nằm trên dải thao tác của người lái (dưới 2 Hz) và dưới tần số

đặc trưng của rung cơ khí, nên lọc được nhiễu lượng tử hoá của bộ thu mà không

làm chậm cảm giác điều khiển.

### 7.4 Phát hiện mất liên lạc

Điều kiện: quá 200 ms không nhận được khung hợp lệ. Với chu kỳ khung điển hình

7–14 ms, ngưỡng này tương đương 14–28 khung liên tiếp bị mất, đủ lớn để không

kích hoạt nhầm do nhiễu ngắn hạn và đủ nhỏ để phản ứng kịp.

## 8. Kiến trúc an toàn

### 8.1 Máy trạng thái cho phép khởi động động cơ

Điều kiện chuyển sang trạng thái arm:

arm ⇔ (sw = 2) ∧ (sw_prev ≠ 2) ∧ (u_th < 1050)

Ba thành phần, mỗi thành phần loại một kịch bản nguy hiểm:

- Phát hiện sườn (sw_prev ≠ 2) yêu cầu một thao tác chuyển trạng thái

chủ động, không chấp nhận trạng thái tĩnh.

- Cần ga ở đáy loại trường hợp arm khi cần ga đang mở.
- Khởi tạo sw_prev = 2 bảo đảm nếu cấp nguồn trong lúc công tắc đã ở vị

trí arm thì điều kiện sườn không thoả. Người dùng phải gạt công tắc ra rồi

gạt lại. Không có chi tiết này, phương tiện có thể tự arm ngay khi cấp nguồn.

Điều kiện sw != 2 gây disarm ngay lập tức, không qua trung gian.

Ghi chú về tính tương thích. Cách phát hiện sườn "vào vị trí 2 từ vị trí bất

kỳ" hoạt động đúng với cả công tắc hai nấc lẫn ba nấc. Cách đặc tả chặt hơn —

đòi chuyển trực tiếp 0 → 2 — sẽ hỏng với công tắc ba nấc, vì cần gạt bắt

buộc đi qua nấc giữa và ở tần số lấy mẫu 500 Hz thì nấc trung gian chắc chắn

được ghi nhận.

### 8.2 Chế độ mất liên lạc

Khi mất tín hiệu trong lúc đang arm, hệ chuyển sang MODE_FAILSAFE với ba hành

vi đồng thời:

1. Giá trị đặt góc nghiêng và tốc độ xoay về không — giữ thăng bằng.
2. Giá trị đặt tốc độ thẳng đứng bằng FAILSAFE_DESCENT_CMS = -60 cm/s. Đây

là hạ có điều khiển: vòng tốc độ thẳng đứng bám theo giá trị đặt, tự bù

ga khi có gió hoặc khi điện áp nguồn sụt. Khác biệt căn bản với việc cắt động

cơ, vốn dẫn tới rơi tự do.

1. Tự disarm khi hội đủ ba điều kiện: cần ga đã ở đáy, |ż| < 5 cm/s,

và trạng thái duy trì quá 2 s. Yêu cầu ba điều kiện đồng thời loại trừ khả

năng disarm nhầm trong pha rơi đều — khi tốc độ đã ổn định nhưng phương tiện

chưa chạm đất.

Điều kiện tiên quyết. Toàn bộ quy trình chỉ kích hoạt khi

sensor_present.baro đúng. Không có nguồn độ cao thì ước lượng tốc độ thẳng

đứng suy biến thành tích phân gia tốc không có hiệu chỉnh, và "hạ có điều

khiển" trở thành điều khiển theo số liệu không tồn tại. Trong trường hợp đó hệ

cắt động cơ ngay.

Đây là ví dụ về nguyên tắc thiết kế đáng chú ý: một cơ chế an toàn phải tự kiểm tra tiền đề của chính nó, và phải suy biến về hành vi đơn giản hơn khi tiền đề không thoả — thay vì thực thi một quy trình phức tạp trên dữ liệu không

đáng tin.

## 9. Phân tích định lượng bổ sung

### 9.1 Ngân sách thời gian vòng điều khiển

Ngân sách 2000 µs mỗi chu kỳ. Thành phần chi phối:

Thành phần | Ước tính | Ghi chú
Hai giao dịch SPI đọc IMU | ~25 µs | 2 × 7 byte ở 10 MHz, kể cả chi phí đóng mở giao dịch
Bốn hàm lượng giác | ~10 µs | sinf/cosf đơn chính xác, FPU phần cứng
Kalman hai trạng thái dạng ma trận | ~15 µs | thư viện mẫu, không cấp phát động
Sáu bộ PID | ~10 µs | mỗi bộ vài phép nhân cộng
Ba lần lấy/nhả mutex | ~6 µs | đường không tranh chấp
Bốn lời gọi ledcWrite | ~4 µs | ghi thanh ghi

Tổng ước tính dưới 100 µs, tức dưới 5% ngân sách. Kết luận: vòng điều khiển

có biên an toàn rất lớn; nút thắt của hệ không nằm ở năng lực tính toán.

Kích thước ảnh nhị phân: 308 369 byte bộ nhớ chương trình (23% dung lượng khả

dụng) và 22 988 byte bộ nhớ dữ liệu tĩnh (7%).

### 9.2 Ảnh hưởng của nhiễu rung

Giả thiết G4 bị vi phạm trong vận hành thực. Nhiễu do cánh quạt là nhiễu hẹp

băng, tần số trung tâm tỉ lệ tốc độ quay:

f_rung = (n_RPM)/60 × n_cánh

Với động cơ quay 6000 v/ph và cánh hai lá, tần số cơ bản khoảng 100 Hz cùng các

hài bậc cao.

Cơ chế phòng vệ duy nhất ở bậc này là bộ lọc thông thấp bên trong ICM-20602: DLPF

5,1 Hz cho con quay và 10 Hz cho gia tốc kế. Băng thông này nằm rất xa dưới dải

nhiễu rung nên suy giảm hiệu quả, nhưng đổi lại đưa vào độ trễ pha đáng kể — với

bộ lọc bậc nhất, độ trễ nhóm ở tần số thấp xấp xỉ 1/(2π f_c) ≈ 31 ms

cho con quay.

Độ trễ này là nguyên nhân chính giới hạn hệ số K_D khả dụng, và qua đó giới

hạn băng thông vòng điều khiển đạt được.

Đây là hạn chế cấu trúc của bậc thiết kế này, không khắc phục được bằng chỉnh tham số. Lý do nằm ở bản chất của bộ lọc thông thấp đơn: hạ tần số cắt thì suy

giảm nhiễu tốt hơn nhưng độ trễ pha tăng theo; nâng tần số cắt thì ngược lại.

Hai đại lượng ràng buộc nhau qua cùng một tham số, nên không tồn tại điểm làm

việc thoả mãn đồng thời cả hai yêu cầu.

Nói cách khác, giới hạn ở đây không phải do chọn sai tần số cắt mà do cấu trúc lọc — muốn vượt qua thì phải thay đổi cách tách nhiễu khỏi tín hiệu hữu ích,

chứ không phải điều chỉnh trong khuôn khổ hiện có.

### 9.3 Đặc tính số học

Toàn bộ tính toán điều khiển dùng số thực độ chính xác đơn, ngoại trừ đa thức bù

áp kế dùng độ chính xác kép vì lý do dải động (§3.3).

Các đại lượng trạng thái nằm trong dải 10⁻³ đến 10³, cách xa hai đầu

dải biểu diễn. Phần tử hiệp phương sai của bộ lọc độ cao có giá trị nhỏ nhất cỡ

q_11 = (Tₛ²/2)²σₐ² ≈ 6,4×10⁻¹¹, vẫn nằm trong dải

chuẩn hoá của số thực đơn (ngưỡng dưới ≈ 1,2×10⁻³⁸). Không có

nguy cơ mất chuẩn hoá.

Hàm pid_step() kẹp đầu ra bằng phép so sánh. Cần lưu ý rằng phép so sánh với

giá trị NaN luôn cho kết quả sai, nên NaN đi qua khâu kẹp mà không bị chặn.

Ở bậc này rủi ro bằng không vì mọi hệ số PID là hằng số biên dịch. Nhận xét được

ghi lại để tham chiếu khi mở rộng sang cấu hình tham số động.

## 10. Hạn chế đã biết

# | Hạn chế | Hệ quả | Hướng khắc phục

Bảng dưới phân loại hạn chế theo bản chất của chúng, không theo cách khắc

phục. Phân biệt này quan trọng: có hạn chế chỉ là chỗ chưa hoàn thiện trong

khuôn khổ hiện tại, có hạn chế là hệ quả tất yếu của tập cảm biến và cấu trúc

ước lượng đã chọn — loại thứ hai không thể xử lý bằng cách sửa mã nguồn.

# | Hạn chế | Hệ quả | Bản chất

L1 | Không có tham chiếu hướng tuyệt đối | Góc hướng trôi; chỉ điều khiển được tốc độ xoay | Ràng buộc quan sát được — không nguồn tin nào trong hệ mang thông tin hướng tuyệt đối
L2 | Mô hình đo gia tốc kế bỏ qua gia tốc chuyển động | Ước lượng góc lệch khi cơ động kéo dài (§4.1) | Ràng buộc quan sát được — một phép đo tổng, hai ẩn số
L3 | Không lọc khâu vi phân | Giới hạn K_D khả dụng | Chưa hoàn thiện; sửa được tại chỗ
L4 | Không bù phi tuyến lực đẩy | Đáp ứng phụ thuộc mức ga | Chưa hoàn thiện; cần đặc tuyến khung máy
L5 | Không bù sụt áp nguồn | Đáp ứng thay đổi theo mức pin | Chưa hoàn thiện; cần thêm phép đo điện áp
L6 | Chỉ có bộ lọc thông thấp đơn để chống nhiễu rung | Giới hạn băng thông vòng điều khiển (§9.2) | Ràng buộc cấu trúc — một tham số, hai yêu cầu ngược nhau
L7 | Không có nguồn vị trí ngang | Không giữ được vị trí | Ràng buộc quan sát được — trạng thái vị trí không quan sát được từ tập cảm biến hiện có
L8 | Chống windup bằng kẹp biên độ đơn thuần | Kém tối ưu khi bão hoà kéo dài | Chưa hoàn thiện; sửa được tại chỗ

Bốn hạn chế L1, L2, L6, L7 thuộc loại ràng buộc, không phải khiếm khuyết.

Chúng là ranh giới phạm vi có chủ đích của bậc thiết kế này. Muốn vượt qua thì

phải mở rộng tập cảm biến hoặc thay đổi cấu trúc ước lượng — tức là bước sang

một bài toán khác, không phải sửa lỗi trong bài toán hiện tại.

Bốn hạn chế còn lại L3, L4, L5, L8 nằm trong khuôn khổ hiện có và có thể khắc

phục mà không thay đổi kiến trúc.

## 11. Kết luận

Hệ thống hiện thực một bộ điều khiển bay hai chế độ trên nền tảng vi điều khiển

hai nhân, với các đặc điểm kiến trúc đáng chú ý:

1. Tách biệt nghiêm ngặt giữa đường điều khiển và đường phụ trợ, được bảo

đảm bằng phân bổ nhân xử lý và bằng nguyên tắc không xuất dữ liệu chẩn đoán

từ vòng điều khiển.

1. Chính sách khoá không chờ, đổi độ tươi của dữ liệu lấy tính tất định về

thời gian — đánh đổi đúng với hệ có ràng buộc thời gian cứng.

1. Truy cập cảm biến ở mức thanh ghi, cho phép kiểm soát các chi tiết quyết

định tính đúng đắn: kiểm tra hiện diện trước khi hiệu chỉnh, cổng dữ liệu

theo cờ sẵn sàng, ràng buộc định thời giữa ODR và OSR.

1. Cơ chế an toàn tự kiểm tra tiền đề, thể hiện rõ nhất ở chế độ mất liên

lạc: quy trình hạ cánh có điều khiển chỉ kích hoạt khi nguồn dữ liệu độ cao

còn hoạt động, ngược lại suy biến về hành vi đơn giản hơn.

1. Đồng nhất bộ tham số với cấu trúc thuật toán, minh hoạ bằng trường hợp bộ

lọc Kalman độ cao (§4.4): bộ tham số chỉ có nghĩa trong ngữ cảnh nhịp chạy mà

nó được xác định cùng.

Điểm 5 mang giá trị phương pháp luận vượt ra ngoài hệ thống cụ thể: nó cho thấy

một thay đổi đúng về mặt lý thuyết thuần tuý vẫn có thể phá hỏng hệ thống nếu

không xét tới các giả định ngầm mà bộ tham số đã mã hoá.

## Phụ lục A. Bảng tham số vận hành

Tham số | Ký hiệu mã nguồn | Giá trị | Đơn vị
Chu kỳ vòng điều khiển | DT_CTRL | 0,002 | s
Góc nghiêng tối đa | LIM_TILT_DEG | 20 | độ
Tốc độ xoay tối đa | LIM_YAW_RATE_DPS | 100 | °/s
Tốc độ lên xuống tối đa | LIM_CLIMB_RATE_CMS | 100 | cm/s
Tốc độ hạ khi mất sóng | FAILSAFE_DESCENT_CMS | −60 | cm/s
Nhiễu quá trình, KF độ cao | KF_SIGMA_ACC_CMS2 | 4,0 | cm/s²
Nhiễu đo, KF độ cao | KF_SIGMA_BARO_CM | 30,0 | cm
Nhiễu quá trình, KF góc | (hằng trong hàm) | 1,0 | °/s
Nhiễu đo, KF góc | (hằng trong hàm) | 3,0 | độ
Ngưỡng hội tụ hiệu chỉnh con quay | STABLE_LIMIT | 40 | tổng của 500 mẫu
Thời gian chờ mất liên lạc | SBUS_TIMEOUT_MS | 200 | ms

## Phụ lục B. Cấu hình đã thẩm định bằng bay thử

Khung | 5 inch
Động cơ | 2204, 2300 KV
Cánh | 5 inch
Nguồn | 3S, 2200 mAh

Bộ tham số điều khiển trong Phụ lục A được xác định cho cấu hình này. Với khung

có mô-men quán tính khác đáng kể, cần xác định lại — trước hết là K_P của vòng

tốc độ góc, tỉ lệ nghịch xấp xỉ với mô-men quán tính quanh trục tương ứng.

## Phụ lục C. Tài liệu tham chiếu

1. TDK InvenSense, *ICM-20602 Datasheet*, mục 4.2 (thang đo), mục 8 (bản đồ thanh ghi).
2. Bosch Sensortec, *BMP388 Datasheet*, mục 3.9.2 (thời gian đo), mục 4.3 (bù nhiệt–áp), mục 5.3 (giao diện số).
3. Espressif Systems, *ESP32 Technical Reference Manual*, chương LEDC, chương UART.
4. Liu, C. L. và Layland, J. W., "Scheduling Algorithms for Multiprogramming in a Hard-Real-Time Environment", *Journal of the ACM*, tập 20, số 1, 1973.
5. Kalata, P. R., "The Tracking Index: A Generalized Parameter for α-β and α-β-γ Target Trackers", *IEEE Transactions on Aerospace and Electronic Systems*, tập AES-20, số 2, 1984.
6. ArduPilot, mã nguồn AC_PID và AC_AttitudeControl — tham chiếu về quy ước cấu trúc phân tầng.
