3XChehe/project-3/ESP32_FC/Tài liệu kèm theo/CAM_NANG_HOC_VA_THUC_HIEN_DRONE_ESP32.docx

TÀI LIỆU HƯỚNG DẪN KỸ THUẬT & TỰ HỌC CHUYÊN SÂU

CẨM NANG HỌC VÀ LẬP TRÌNH
FLIGHT CONTROLLER CHO DRONE (ESP32)

Từ Cơ Sở Động Lực Học, Lý Thuyết Điều Khiển, Thuật Toán Kalman & Cascaded PID Đến Thực Hành Bay Trên Phần Cứng ESP32

Dự án mã nguồn: | Mạch bay ESP32 — Kỹ Thuật UAV (Level 1: Angle + Alt Hold)
Tác giả dự án: | Nguyễn Văn Quý (Kỹ Thuật UAV — 0817 550 271)
Nguồn học thuật: | Carbon Aeronautics (Belgium), Bosch Sensortec, TDK InvenSense
Nền tảng nhúng: | ESP32-WROOM-DA (Dual-Core 240MHz, FreeRTOS, Core 2.0.17)
Cảm biến & Điều khiển: | ICM-20602 (SPI 10MHz), BMP388 (I2C), SBUS RC (UART2), 4 ESC LEDC PWM

LỜI NÓI ĐẦU DÀNH CHO NGƯỜI MỚI

Chào bạn! Khi bạn bắt đầu làm quen với lĩnh vực phương tiện bay không người lái (UAV/Drone), việc lựa chọn tự xây dựng một bộ điều khiển bay (Flight Controller — FC) từ mức thanh ghi và toán học thay vì chỉ đơn thuần mua bo mạch thương mại cài đặt phần mềm có sẵn là một quyết định học tập vô cùng xuất sắc. Con đường này sẽ giúp bạn làm chủ 100% bản chất vật lý, cơ chế thời gian thực của hệ thống nhúng và các thuật toán ước lượng trạng thái hiện đại.

Tài liệu này được biên soạn nhằm giải thích toàn diện mọi khía cạnh bạn cần biết để học, nạp mã nguồn, cân chỉnh và tự tin cho chiếc drone của bạn cất cánh thành công.

[CẢNH BÁO AN TOÀN TUYỆT ĐỐI] QUY TẮC AN TOÀN SỐNG CÒN:
Luôn tháo cánh quạt ra khỏi động cơ trong suốt quá trình cài đặt phần mềm, nạp code, hiệu chỉnh cảm biến và thử nghiệm trên bàn làm việc. Động cơ không chổi than (Brushless Motor) quay ở tốc độ hàng chục ngàn vòng/phút có thể gây sát thương cực kỳ nghiêm trọng nếu vô tình nhảy ga!

CHƯƠNG 1: TỔNG QUAN HỆ THỐNG VÀ PHẦN CỨNG

Dự án Mạch bay ESP32 là một bộ điều khiển bay mã nguồn mở hoàn chỉnh cho cấu hình Quadcopter chữ X. Điểm nổi bật nhất của dự án là không phụ thuộc vào các thư viện cảm biến cồng kềnh mà tự giao tiếp trực tiếp qua thanh ghi SPI và I2C theo đúng datasheet chính hãng.

1.1 Bảng phân bổ linh kiện và chuẩn giao tiếp

Thành phần | Linh kiện sử dụng | Giao tiếp phần cứng | Tần số & Vai trò
Vi điều khiển (MCU) | ESP32-WROOM-DA | Nội bộ SoC | 240 MHz Dual-Core, chạy FreeRTOS
Cảm biến IMU | ICM-20602 (TDK) | SPI (CS = GPIO 5) | 10 MHz; Đọc Gyro (±2000°/s) & Accel (±16g)
Cảm biến áp suất | BMP388 (Bosch) | I2C (GPIO 21/22) | 400 kHz; Đo áp suất khí quyển tính độ cao
Bộ thu sóng (RX) | Mọi RX ra chuẩn SBUS | UART2 (GPIO 35) | 100.000 baud, 8E2, tín hiệu đảo phần cứng
Điều khiển động cơ | 4 ESC + Brushless Motor | LEDC PWM (GPIO 27,26,25,33) | 391 Hz, 11-bit (độ rộng xung 1000 - 2000 µs)

1.2 Các chế độ bay đã tích hợp trong Firmware

- Chế độ ANGLE (Cân bằng tự động): Góc nghiêng của drone (Roll và Pitch) tỉ lệ thuận với độ lệch cần gạt trên tay điều khiển. Khi thả cần về giữa, drone tự động khôi phục vị trí cân bằng nằm ngang.
- Chế độ ALT HOLD (Giữ độ cao): Cần ga quy định tốc độ leo dốc hoặc hạ cánh. Khi giữ cần ga ở chính giữa (1500 µs), drone sẽ tự động khóa độ cao nhờ sự kết hợp giữa cảm biến áp suất và gia tốc kế.
- Chế độ FAILSAFE (Tự hạ cánh khẩn cấp khi mất sóng): Khi mất tín hiệu tay điều khiển quá 200ms, firmware không tắt động cơ đột ngột (làm rơi máy) mà tự động cân bằng góc về 0, hạ cánh êm dịu ở tốc độ 60 cm/s, phát hiện chạm đất và tự động ngắt máy.

CHƯƠNG 2: CƠ SỞ VẬT LÝ VÀ ĐỘNG LỰC HỌC QUADCOPTER

Để điều khiển được một phương tiện bay 4 cánh quạt, ta cần nắm vững các định luật cơ học cổ điển Newton-Euler mô tả chuyển động vật thể rắn trong không gian 3 chiều.

2.1 Các hệ quy chiếu và 6 bậc tự do chuyển động

Hệ thống bay xét trên hai hệ tọa độ chính:

- Hệ quy chiếu mặt đất (Earth Frame): Hệ quy chiếu quán tính gắn liền với Trái Đất. Trục Z vuông góc mặt đất hướng lên trên (hoặc hướng xuống theo chuẩn NED).
- Hệ quy chiếu thân máy bay (Body Frame): Gốc tọa độ đặt tại trọng tâm drone. Trục X hướng về phía trước (mũi máy), trục Y hướng sang bên phải, trục Z hướng vuông góc với mặt phẳng thân máy.

Drone có tổng cộng 6 bậc tự do (6 Degrees of Freedom — DoF):

- 3 bậc tịnh tiến: Chuyển động dọc trục X (tiến/lùi), trục Y (trái/phải) và trục Z (nâng/hạ).
- 3 bậc quay: Roll (phi - nghiêng cánh quanh X), Pitch (theta - chúc/ngửa mũi quanh Y), Yaw (psi - xoay hướng mũi quanh Z).

2.2 Nguyên lý sinh lực nâng và triệt tiêu moment quay (Torque Reaction)

Khi cánh quạt quay với tốc độ góc omega (rad/s), nó sinh ra lực nâng khí động học tỉ lệ với bình phương tốc độ quay: T = k_T * omega^2. Đồng thời, không khí cản trở chuyển động quay tạo ra một moment xoắn phản lực (Drag Torque): M = k_D * omega^2 tác động ngược chiều lên thân máy.

Để thân drone không bị tự xoay tròn liên tục trong không trung, người ta bố trí 4 cánh quạt quay xen kẽ nhau:

- Cặp cánh quay thuận chiều kim đồng hồ (CW): Motor 1 và Motor 4.
- Cặp cánh quay ngược chiều kim đồng hồ (CCW): Motor 2 và Motor 3.

Khi muốn quay đầu (Yaw), vi điều khiển sẽ tăng tốc cặp cánh CW và giảm tốc cặp cánh CCW (hoặc ngược lại). Khi đó tổng lực nâng không đổi nhưng moment xoắn bị lệch, làm drone xoay quanh trục thẳng đứng một cách mượt mà.

2.3 Ma trận hòa trộn tín hiệu động cơ (Mixer Matrix Quad X)

Thuật toán điều khiển tính toán ra 4 giá trị điều khiển mong muốn: u_throttle (lực nâng tổng), u_roll (moment lăn), u_pitch (moment chúi), u_yaw (moment xoay). Ma trận Mixer sẽ biến đổi 4 biến này thành xung cấp cho 4 động cơ:

// Bộ trộn tín hiệu cho cấu hình Quad chữ X (control_task.ino)
esc_1 = u_throttle - u_roll - u_pitch - u_yaw; // Phía sau - Phải
esc_2 = u_throttle + u_roll + u_pitch - u_yaw; // Phía trước - Phải
esc_3 = u_throttle + u_roll - u_pitch + u_yaw; // Phía sau - Trái
esc_4 = u_throttle - u_roll + u_pitch + u_yaw; // Phía trước - Trái

2.4 Phân rã gia tốc trọng trường về trục thẳng đứng mặt đất

Gia tốc kế đo tổng gia tốc tác động lên cảm biến, bao gồm phản lực của trọng lực Trái Đất (1.0 g hướng lên). Khi drone nghiêng một góc Roll (phi) và Pitch (theta), vector trọng lực 1g bị phân bố vào cả ba trục X, Y, Z của thân máy. Để biết drone thực sự đang tăng tốc rơi hay bay lên so với mặt đất, ta thực hiện phép chiếu hình học:

// Chiếu gia tốc từ Body Frame sang Earth Frame (control_task.ino)
float sr = sinf(roll_deg * DEG_TO_RAD), cr = cosf(roll_deg * DEG_TO_RAD);
float sp = sinf(pitch_deg * DEG_TO_RAD), cp = cosf(pitch_deg * DEG_TO_RAD);

// Gia tốc tịnh tiến thẳng đứng (đã triệt tiêu 1.0g trọng lực tĩnh):
acc_earth_z_g = -sp * acc_x_g + cp * sr * acc_y_g + cp * cr * acc_z_g - 1.0f;

CHƯƠNG 3: CƠ SỞ THUẬT TOÁN ĐIỀU KHIỂN & ƯỚC LƯỢNG TRẠNG THÁI

Một chiếc drone không thể bay ổn định chỉ bằng cách đọc cảm biến thô và xuất trực tiếp ra động cơ. Dự án tích hợp các thuật toán xử lý tín hiệu và điều khiển vòng kín tinh vi bậc nhất.

3.1 Ước lượng góc nghiêng Roll/Pitch bằng Bộ Lọc Kalman 1 Chiều

Bài toán: Con quay hồi chuyển (Gyro) đo tốc độ góc (độ/giây) cực kỳ nhanh, không bị ảnh hưởng bởi độ rung cơ học, nhưng khi lấy tích phân theo thời gian để tính góc nghiêng thì bị trôi dạt (Drift) do sai số tĩnh (bias). Ngược lại, gia tốc kế (Accelerometer) xác định hướng vector trọng lực để tính góc tuyệt đối qua hàm arctan thì không bao giờ bị trôi, nhưng lại chứa đầy nhiễu rung từ động cơ.

Thuật toán Kalman Filter 1D kết hợp điểm mạnh của cả hai cảm biến:

- 1. Bước dự đoán (Predict): Dùng số đo Gyro để cập nhật góc dự đoán và mở rộng phương sai sai số ước lượng theo thời gian dt.
- 2. Bước tính độ lợi Kalman (Gain): K = Variance / (Variance + R), xác định mức độ tin tưởng vào phép đo gia tốc kế.
- 3. Bước hiệu chỉnh (Update): Hiệu chỉnh góc dự đoán dựa trên sai lệch với góc đo từ gia tốc kế, đồng thời thu hẹp phương sai sai số.

void imu_kalman_1d(float &state_deg, float &variance, float rate_dps, float measure_deg) {
// 1. Dự đoán trạng thái từ Gyroscope
state_deg += DT_CTRL * rate_dps;
variance += DT_CTRL * DT_CTRL * 1.0f; // Nhiễu quá trình Q

// 2. Tính độ lợi Kalman
float gain = variance / (variance + 3.0f * 3.0f); // Nhiễu đo R

// 3. Hiệu chỉnh theo góc đo từ Gia tốc kế
state_deg += gain * (measure_deg - state_deg);
variance = (1.0f - gain) * variance;
}

3.2 Ước lượng Độ Cao và Tốc Độ Leo Bằng Bộ Lọc Kalman Ma Trận 2D

Cảm biến áp suất khí quyển BMP388 cho biết độ cao tuyệt đối nhưng có nhược điểm: tần số cập nhật chậm (50Hz) và dễ bị ảnh hưởng bởi luồng gió quẩn của cánh quạt. Gia tốc kế trục Z phản ứng tức thời ở 500Hz nhưng bị trôi nếu tích phân 2 lần.

Bộ lọc Kalman 2 trạng thái trong altitude_kf.ino hợp nhất hai nguồn dữ liệu này:

- Vector trạng thái S: Gồm độ cao z (cm) và vận tốc thẳng đứng v_z (cm/s).
- Tín hiệu đầu vào u: Gia tốc đứng acc_earth_z (cm/s^2) lấy từ IMU.
- Phép đo M: Độ cao z_baro (cm) chuyển đổi từ áp suất của BMP388.
- Ma trận chuyển trạng thái F và ma trận đầu vào G:

// Không gian trạng thái rời rạc của mô hình chuyển động rơi tự do:
Fz = [ 1, DT_CTRL ] Gz = [ 0.5 * DT_CTRL^2 ]
[ 0, 1 ] [ DT_CTRL ]

// Dự đoán:
Sz = Fz * Sz + Gz * Acczz;
Pz = Fz * Pz * ~Fz + Qz;

// Hiệu chỉnh theo Baro:
Kz = Pz * ~Hz * (1.0f / (Hz * Pz * ~Hz + Rz));
Sz = Sz + Kz * (Mz - Hz * Sz);
Pz = (Iz - Kz * Hz) * Pz;

Kết quả: Hệ thống có được vận tốc leo dốc thẳng đứng v_z (climb rate) cực kỳ chính xác và mượt mà, giúp chế độ Alt Hold phản ứng chống lún hoặc vọt độ cao gần như tức thì.

3.3 Cấu trúc Điều Khiển PID Xếp Tầng (Cascaded PID Controller)

Trong điều khiển drone, việc dùng một bộ PID trực tiếp từ sai số góc ra lực đẩy động cơ sẽ khiến hệ thống rất dễ mất ổn định hoặc dao động mạnh. Giải pháp chuẩn mực quốc tế là sử dụng cấu trúc PID xếp tầng (Cascaded Loop):

- Vòng ngoài (Angle/Tilt Controller): So sánh Góc mong muốn từ cần gạt RC với Góc thực tế từ Kalman. Đầu ra của khâu này chính là TỐC ĐỘ GÓC MONG MUỐN (đơn vị độ/giây). Khâu này thường chỉ dùng hệ số P (Kp).
- Vòng trong (Rate Controller — Tần số cao 500 Hz): So sánh Tốc độ góc mong muốn với Tốc độ góc thực tế đo trực tiếp từ Gyroscope. Vòng này sử dụng đầy đủ 3 thành phần P, I, D để tính ra tín hiệu moment điều khiển u. Vòng trong phản ứng siêu nhanh để dập tắt rung lắc trước khi góc nghiêng kịp thay đổi.

3.4 Kỹ thuật Chống Bão Hòa Tích Phân (Anti-Windup) và Xả Tích Phân (Bleed)

- Chống bão hòa tích phân (Anti-windup): Khâu I được giới hạn chặt chẽ (I_LIM). Khi động cơ chạm trần công suất tối đa hoặc khi bị cản trở cơ học, khâu I không bị tích lũy lên vô hạn, tránh hiện tượng drone lật nhào khi vừa thoát tải.
- Xả tích phân khi hạ ga (Bleed Integrators): Khi cần ga kéo xuống đáy (u_throttle < 830), hàm pid_bleed_integrators() sẽ nhân khâu tích phân với 0.9 ở mỗi vòng để giảm dần về 0. Điều này ngăn chặn hiện tượng drone tự tích lũy sai số và giật mạnh khi còn đang nằm trên mặt đất chuẩn bị cất cánh.

CHƯƠNG 4: KIẾN TRÚC PHẦN MỀM THỜI GIAN THỰC FREERTOS

ESP32 sở hữu vi xử lý lõi kép (Dual-Core). Firmware được thiết kế để phân chia tải công việc tối ưu giữa 2 nhân, đảm bảo vòng điều khiển bay không bao giờ bị nghẽn.

Tên Task | Nhân (Core) | Tần số | Ưu tiên | Nhiệm vụ chính
control_task | Core 1 | 500 Hz (2ms) | Priority 5 (Cao nhất) | Đọc IMU SPI, Kalman góc & độ cao, PID, Mixer, xuất ESC
rc_task | Core 0 | 500 Hz (2ms) | Priority 4 | Nhận UART SBUS, kiểm tra tính toàn vẹn 25 byte, giải mã 16 kênh
baro_task | Core 0 | 100 Hz (10ms) | Priority 2 (Thấp) | Đọc I2C BMP388 (chờ bit DRDY), in dữ liệu Telemetry/Debug ra Serial

4.1 Cơ chế trao đổi dữ liệu phi phong tỏa (Non-blocking Mutex)

Để trao đổi dữ liệu giữa các task trên 2 nhân khác nhau (như shared_rc_ch, shared_baro_alt_m, dữ liệu Telemetry để in debug), hệ thống sử dụng Mutex của FreeRTOS nhưng với thời gian chờ bằng 0:

if (xSemaphoreTake(mtx_baro, 0) == pdTRUE) {
baro_alt_m = shared_baro_alt_m;
xSemaphoreGive(mtx_baro);
}

Ý nghĩa kỹ thuật: Vòng điều khiển bay ở Core 1 TUYỆT ĐỐI KHÔNG BAO GIỜ BỊ CHỜ ĐỢI (không bao giờ block). Nếu Mutex đang bị chiếm bởi Core 0, Core 1 sẽ tiếp tục dùng số liệu của chu kỳ trước đó mà không làm suy chuyển tần số lấy mẫu cố định 500 Hz.

4.2 Giải phóng loopTask mặc định của Arduino

Trong setup(), sau khi khởi tạo thành công 3 task FreeRTOS, mã nguồn gọi hàm vTaskDelete(NULL). Lệnh này sẽ xóa bỏ tác vụ loop() ngầm định của Arduino, thu hồi toàn bộ vùng nhớ Stack của nó về cho hệ thống, tối ưu hóa bộ nhớ RAM của vi điều khiển.

CHƯƠNG 5: HƯỚNG DẪN CÀI ĐẶT MÔI TRƯỜNG & CẠM BẪY PHẦN MỀM

Để biên dịch và nạp firmware thành công, người mới bắt đầu cần tuyệt đối tuân thủ đúng phiên bản công cụ.

[LƯU Ý CỐT TỬ VỀ TRÌNH BIÊN DỊCH] CẠM BẪY PHIÊN BẢN ESP32 CORE:
Bắt buộc cài gói board esp32 phiên bản 2.0.17 (Espressif Systems). KHÔNG ĐƯỢC CÀI BẢN 3.x!

Lý do: Từ phiên bản 3.0.0, Espressif đã xóa bỏ hoàn toàn cơ chế gán kênh của bộ phát xung LEDC (các hàm ledcSetup, ledcAttachPin không còn tồn tại). Nếu cài bản 3.x, phần mềm sẽ báo lỗi biên dịch ngay lập tức.

5.1 Các bước cài đặt chi tiết trên Arduino IDE 2.x

- Bước 1: Tải và cài đặt Arduino IDE 2.x từ trang chủ arduino.cc.
- Bước 2: Cài Driver giao tiếp USB nếu máy tính chưa nhận cổng COM (CP210x hoặc CH340 tùy loại mạch nạp). Thư mục 'driver esp32' trong project đã có sẵn bộ cài.
- Bước 3: Mở Arduino IDE -> File -> Preferences. Dán đường dẫn URL sau vào ô Additional boards manager URLs: https://espressif.github.io/arduino-esp32/package_esp32_index.json
- Bước 4: Vào Tools -> Board -> Boards Manager. Tìm từ khóa 'esp32'. Chọn phiên bản đúng 2.0.17 và nhấn Install.
- Bước 5: Vào Tools -> Manage Libraries. Tìm thư viện 'BasicLinearAlgebra' của tác giả Tom Stewart và nhấn Install.
- Bước 6: Vào menu Tools, thiết lập thông số board: - Board: ESP32-WROOM-DA Module - Upload Speed: 921600 (hoặc 115200 nếu cáp nạp chập chờn) - Flash Frequency: 80MHz - Partition Scheme: Default 4MB with spiffs

CHƯƠNG 6: QUY TRÌNH CÂN CHỈNH (CALIBRATION) VÀ KIỂM TRA TRƯỚC KHI BAY

Một chiếc drone nạp code thành công chưa đồng nghĩa với việc nó bay được. Bắt buộc phải thực hiện đầy đủ các bước kiểm tra sau khi chưa gắn cánh quạt.

6.1 Hiệu chỉnh Gyroscope (Tự động lúc khởi động)

Mỗi lần cắm pin/cắm nguồn, firmware sẽ tự động bước vào chế độ cân bằng Gyro. Đèn LED trên chân 14 sẽ sáng liên tục. Firmware sẽ lặp lại quá trình đo cho đến khi drone thực sự đứng yên hoàn toàn. Do đó, hãy đặt drone xuống mặt bàn phẳng, buông tay ra và không chạm vào bàn cho đến khi nghe tiếng hoặc thấy Serial báo 'cali gyro thanh cong'.

6.2 Hiệu chỉnh Gia tốc kế (Accelerometer Calibration) — Làm 1 lần duy nhất

Vì sao phải làm: Trục Z của gia tốc kế nuôi dữ liệu trực tiếp vào bộ lọc Kalman ước lượng độ cao. Nếu cảm biến bị lệch dù chỉ 0.01g, nó tương đương với sai số gia tốc 9.8 cm/s^2 liên tục nạp vào bộ lọc khiến drone bị trôi độ cao không thể kiểm soát.

Cách thực hiện:

- 1. Mở file KyThuatUAV_FC_level_1.ino, tìm đến khối CẤU HÌNH và bỏ chú thích dòng: #define CALIBRATE_ACCEL
- 2. Nạp code vào ESP32. Đặt drone nằm thật phẳng trên mặt bàn tĩnh.
- 3. Mở Serial Monitor ở tốc độ 500000 baud. Mạch đếm ngược 5 giây và đo trong 4 giây.
- 4. Màn hình sẽ in ra 3 dòng mã định nghĩa bù lệch:

#define ACC_OFFSET_X_G +0.0213f
#define ACC_OFFSET_Y_G -0.0087f
#define ACC_OFFSET_Z_G +0.0069f

- 5. Sao chép 3 dòng này dán đè vào vị trí cũ trong khối CẤU HÌNH. Sau đó chú thích lại (thêm dấu //) trước dòng #define CALIBRATE_ACCEL và nạp lại code.

6.3 Kiểm tra 3 bước an toàn bắt buộc trước khi lắp cánh

Mục kiểm tra | Cách bật trong mã nguồn | Hiện tượng ĐÚNG tiêu chuẩn
Kênh tay điều khiển | #define DEBUG_RC | Gạt Roll, Pitch, Yaw, Throttle trên tay phát thì các kênh tương ứng hiển thị biến thiên 1000 - 2000. Công tắc Arm và Switch Mode nhảy đúng các nấc 0, 1, 2.
Thứ tự & Chiều quay Motor | Mở khối test motor trong esc_output.ino | Lần lượt từng motor 1 -> 2 -> 3 -> 4 sẽ quay nhẹ theo thứ tự. Kiểm tra chiều quay khớp hoàn toàn với sơ đồ Quad X.
Chiều phản hồi cảm biến | #define DEBUG_ATTITUDE | Nghiêng drone sang phải thì giá trị roll tăng dương; gạt cần roll sang phải thì roll_sp cũng tăng dương. Cảm biến và cần gạt BẮT BUỘC PHẢI CÙNG CHIỀU!

CHƯƠNG 7: QUY TRÌNH BAY THỬ VÀ KINH NGHIỆM CHỈNH ĐỊNH PID

Bộ thông số PID mặc định trong mã nguồn đã được bay thử nghiệm và nghiệm thu thực tế trên cấu hình chuẩn: Khung carbon 5 inch, Động cơ 2204 - 2300KV, Cánh quạt 5 inch, Pin LiPo 3S 2200mAh.

7.1 Quy tắc an toàn cho lần cất cánh đầu tiên

- Kiểm tra không gian: Chọn bãi cỏ rộng, thoáng đãng, tuyệt đối không có người đứng gần trong bán kính 10 mét.
- Buộc dây giới hạn (Tethering): Với người mới, nên buộc 4 sợi dây dù chùng ở 4 góc chân đáp nối xuống cọc đất. Chiều dài dây vừa đủ để drone nhấc bổng 30-50 cm. Nếu có bất kỳ hiện tượng lật hay xoay mất kiểm soát, dây sẽ giữ lại an toàn.
- Thao tác Arm: Đưa cần ga về vị trí thấp nhất (dưới 1050 µs), gạt công tắc Arm sang nấc bật. Động cơ sẽ quay ở tốc độ không tải (ESC_MIN_ARMED = 900). Đẩy nhẹ cần ga để cất cánh.

7.2 Cẩm nang tinh chỉnh PID khi thay đổi cấu hình phần cứng

Nếu khung drone của bạn to hơn, nặng hơn, hoặc dùng động cơ và pin khác cấu hình chuẩn, bạn cần tinh chỉnh lại các hệ số PID trong KyThuatUAV_FC_level_1.ino theo các quy tắc sau:

- Khung to và nặng hơn (ví dụ khung 7-10 inch): Drone phản ứng quán tính chậm hơn. Bạn cần GIẢM KP_RATE_ROLL và KP_RATE_PITCH. Giữ nguyên hệ số cao của khung nhỏ sẽ làm drone dao động mất ổn định.
- Động cơ bị nóng hoặc phát tiếng rít tần số cao: Đây là dấu hiệu của khâu vi phân D quá lớn khiến nhiễu tần số cao bị khuếch đại vào động cơ. Khắc phục: GIẢM KD_RATE_ROLL và KD_RATE_PITCH.
- Drone bị lắc lư chậm biên độ lớn: Khâu tỉ lệ P quá lớn hoặc tích phân I bị lệch. Khắc phục: Giảm KP_RATE trước, nếu vẫn chưa hết thì giảm tiếp KI_RATE.
- Drone trôi dạt góc nghiêng khi thả cần: Kiểm tra lại cân chỉnh gia tốc kế (ACC_OFFSET) hoặc tăng nhẹ KP_TILT_ROLL / KP_TILT_PITCH.

CHƯƠNG 8: TỔNG KẾT VÀ ĐỊNH HƯỚNG PHÁT TRIỂN

Dự án Level 1 này là bước đệm vững chắc nhất để bạn thấu hiểu toàn bộ nguyên lý của một hệ thống điều khiển bay tự động. Sau khi đã thuần thục việc bay cân bằng (Angle) và giữ độ cao (Alt Hold), bạn có thể tự tin tiếp tục nâng cấp hệ thống lên các cấp độ cao hơn:

- Cấp độ 2 (Giữ vị trí — Loiter/Position Hold): Tích hợp cảm biến định vị vệ tinh GPS, la bàn số (Magnetometer) hoặc Optical Flow + Lidar để drone đứng yên một điểm trong không gian.
- Cấp độ 3 (Xử lý nhiễu nâng cao): Áp dụng bộ lọc Notch Filter thích ứng theo dõi tần số quay của động cơ, giúp triệt tiêu hoàn toàn nhiễu rung cơ học, cho phép đẩy hệ số PID lên cao hơn mà động cơ vẫn mát rượi.
- Cấp độ 4 (Tự hành thông minh): Giao tiếp với máy tính nhúng (Raspberry Pi / Jetson Nano) qua MAVLink để thực hiện các nhiệm vụ bay tự động theo lộ trình (Waypoints) hoặc tránh vật cản bằng thị giác máy tính.

[LỜI CHÚC TỪ DỰ ÁN] Chúc bạn lắp ráp và cất cánh thành công chuyến bay đầu tiên!
Mọi thắc mắc kỹ thuật có thể tham khảo thêm các tài liệu trong thư mục 'Tài liệu kèm theo' hoặc trao đổi trực tiếp trên các diễn đàn chuyên môn.
