3XChehe/project-3/ESP32_FC/Tài liệu kèm theo/danh_sach_linh_kien_va_thong_tin_khoa_hoc/danh sách linh kiện.pdf

| TÊN LINH KIỆN SỐ LƯỢNG GIÁ THÀNH TIỀN GHI CHÚ LINK SẢN PHẨM LINK DỰ PHÒNG

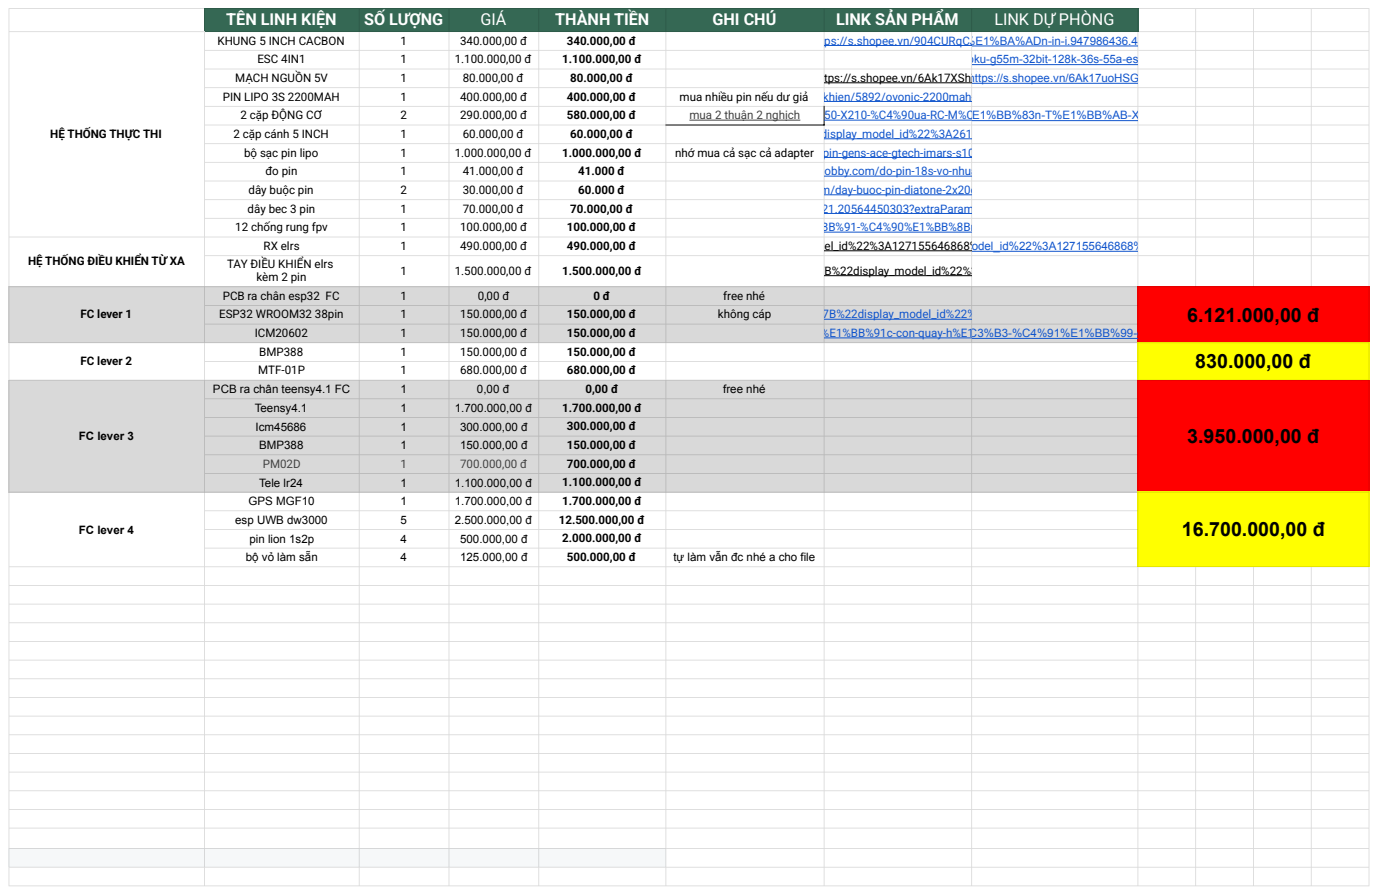
[picture p1: page 1]
2 cặp ĐỘNG CƠ; mua 2 thuận 2 nghịch; 2 cặp cánh 5 INCH; bộ sạc pin lipo; nhớ mua cả sạc cả adapter; đo pin; dây buộc pin; dây bec 3 pin; 12 chống rung fpv; RX elrs; kèm 2 pin

HỆ THỐNG THỰC THI | KHUNG 5 INCH CACBON 1 340.000,00 đ 340.000,00 đ https://s.shopee.vn/904CURqCJA (https://shopee.vn/9IMOD-Mark4-5inch-FPV-Racing-Drone-Frame-225mm-v%E1%BB%9Bi-5mm-C%C3%A1nh-tay-3K-S%E1%BB%A3i-Carbon-5-FPV-Freestyle-RC-Racing-Drone-v%E1%BB%9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) ESC 4IN1 1 1.100.000,00 đ 1.100.000,00 đ MẠCH NGUỒN 5V 1 80.000,00 đ 80.000,00 đ https://s.shopee.vn/6Ak17XShiVhttps://s.shopee.vn/6Ak17uoHSG PIN LIPO 3S 2200MAH 1 400.000,00 đ 400.000,00 đ mua nhiều pin nếu dư giả

HỆ THỐNG ĐIỀU KHIỂN TỪ XA

TAY ĐIỀU KHIỂN elrs

PCB ra chân esp32 FC 1 0,00 đ 0 đ free nhé ESP32 WROOM32 38pin 1 150.000,00 đ 150.000,00 đ không cáp FC lever 1 ICM20602 1 150.000,00 đ 150.000,00 đ | 6.121.000,00 đ

BMP388 1 1 150.000,00 đ 680.000,00 đ 150.000,00 đ 680.000,00 đ FC lever 2 | 830.000,00 đ MTF-01P

PCB ra chân teensy4.1 FC 1 0,00 đ 0,00 đ free nhé Teensy4.1 1 1.700.000,00 đ 1.700.000,00 đ Icm45686 1 300.000,00 đ 300.000,00 đ FC lever 3 BMP388 1 150.000,00 đ 150.000,00 đ PM02D 1 700.000,00 đ 700.000,00 đ Tele lr24 1 1.100.000,00 đ 1.100.000,00 đ | 3.950.000,00 đ

GPS MGF10 1 1.700.000,00 đ 1.700.000,00 đ 5 2.500.000,00 đ 12.500.000,00 đ FC lever 4 pin lion 1s2p 4 500.000,00 đ 2.000.000,00 đ bộ vỏ làm sẵn 4 125.000,00 đ 500.000,00 đ tự làm vẫn đc nhé a cho file | 16.700.000,00 đ esp UWB dw3000
