3XChehe/project-3/(commit log)

2026-10-07 adjust spi read-write
2026-10-08 tích hợp bù nhiễu acc
2026-10-15 thêm lại tự chỉnh acc offset
2026-10-22 thêm bản để đánh giá
2026-11-02 chỉnh offset
