3XChehe/project-3/(notices)

Notices in the files:
ESP32_FC/CODE_FC/DroneFC_CRSF_DShot_ManualAcc_after_change/pid.ino:
PID cascade tham khao Carbon Aeronautics. License: GPL-3.0.
